BlueFrimFrim/Tardis/README.md

# Tardis_GIT

## DTMF
Uses MC8880C 20-pin DIP
