BlueFrimFrim/Tardis/PCB/Tardis.pdf

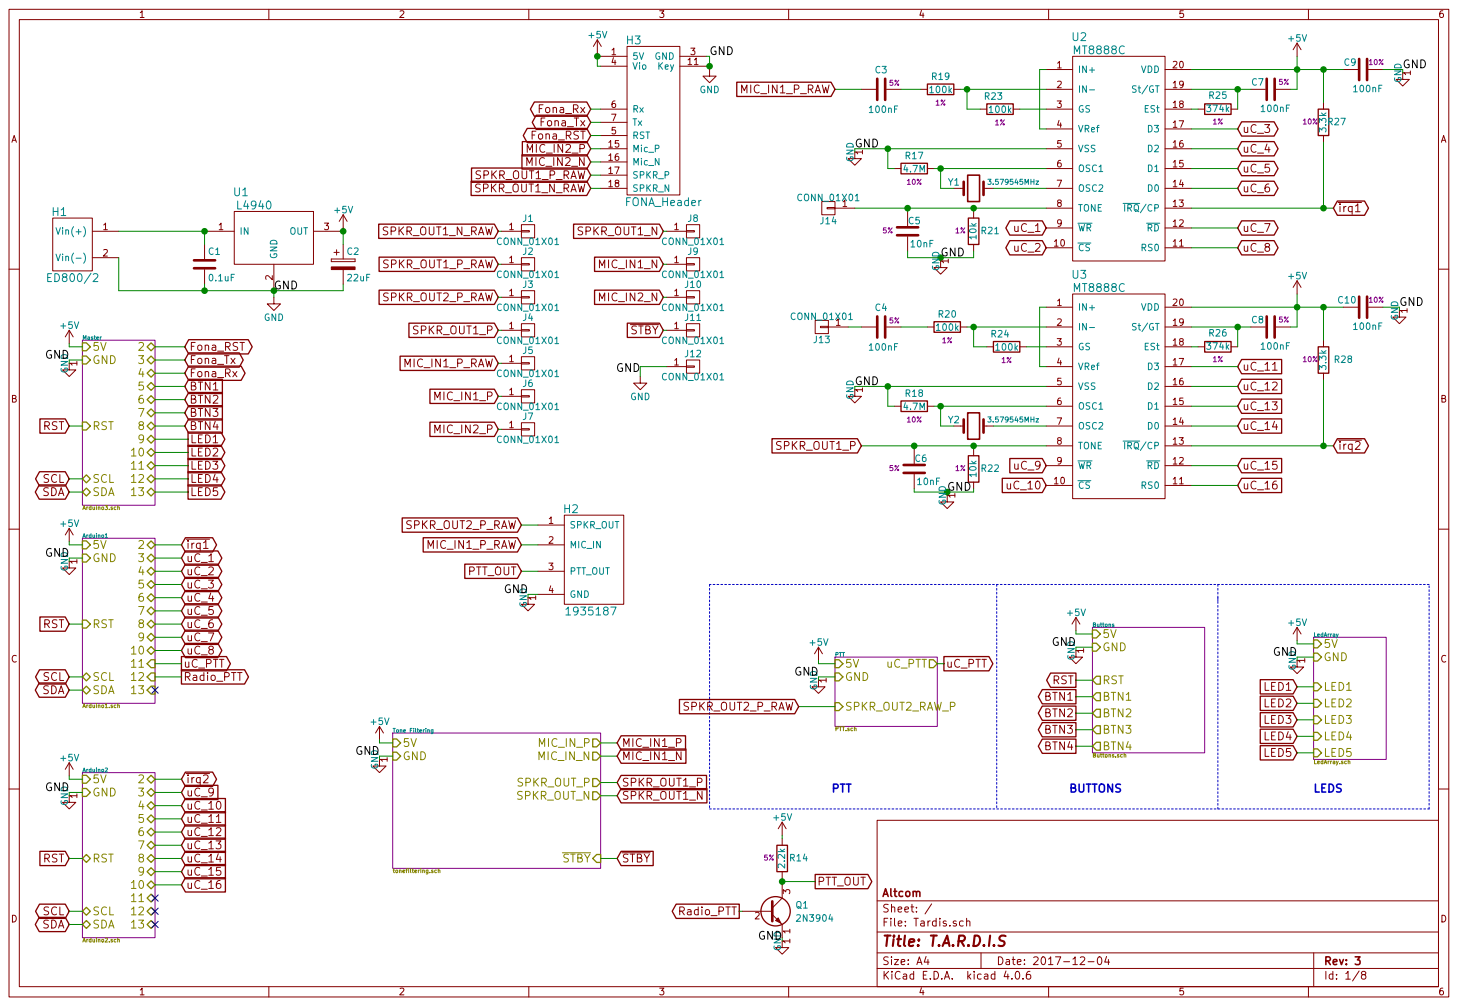
[picture p12: page 1]

File: Tardis.sch Sheet: / Altcom

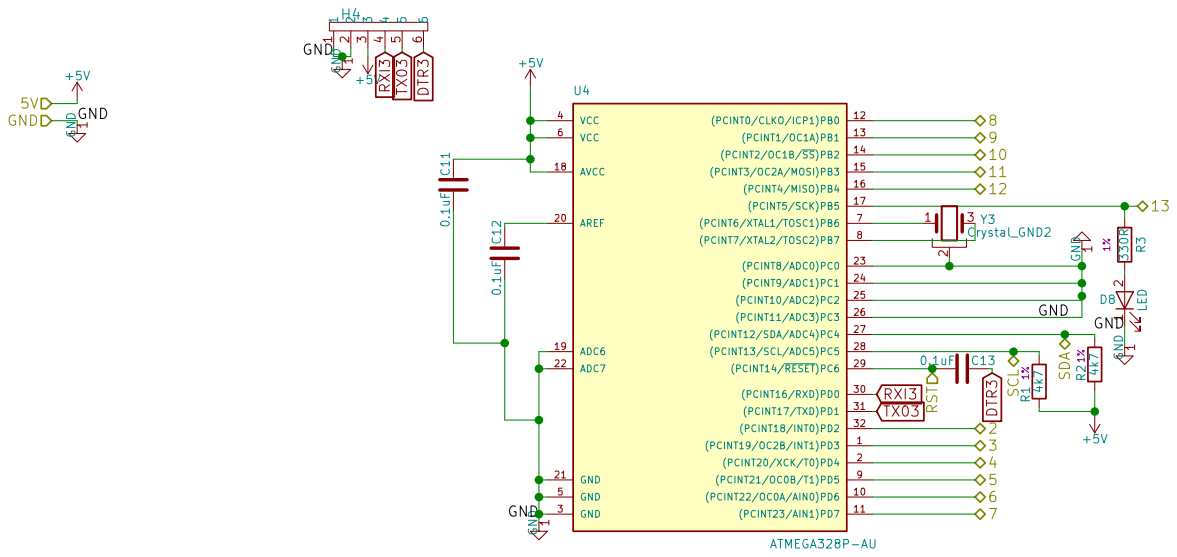
[picture p13: page 2]

File: Arduino2.sch Sheet: /Arduino2/ Altcom

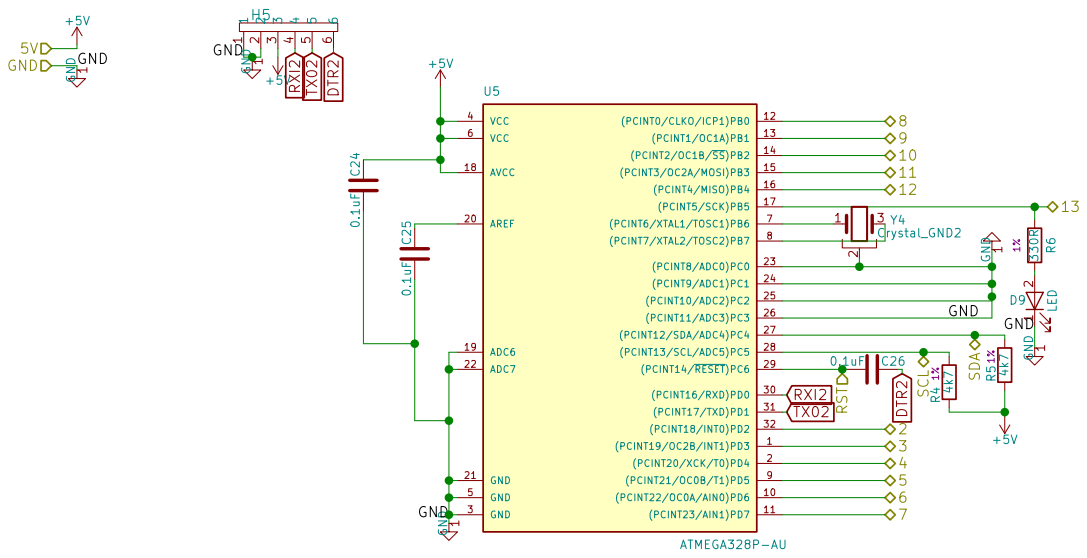
[picture p14: page 3]

File: Arduino1.sch Sheet: /Arduino1/ Altcom

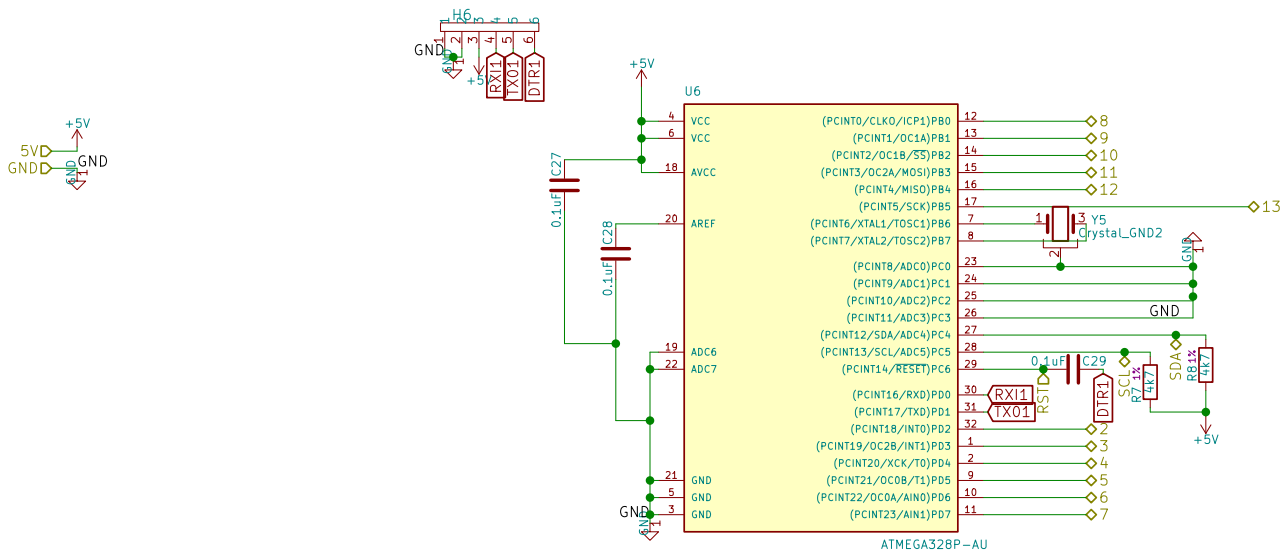
[picture p15: page 4]

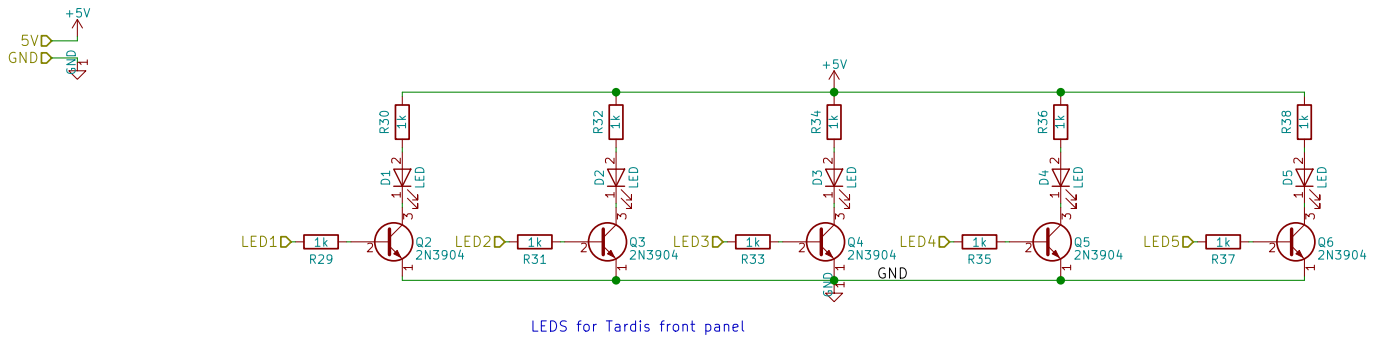
[picture p16: page 5]

LEDS for Tardis front panel

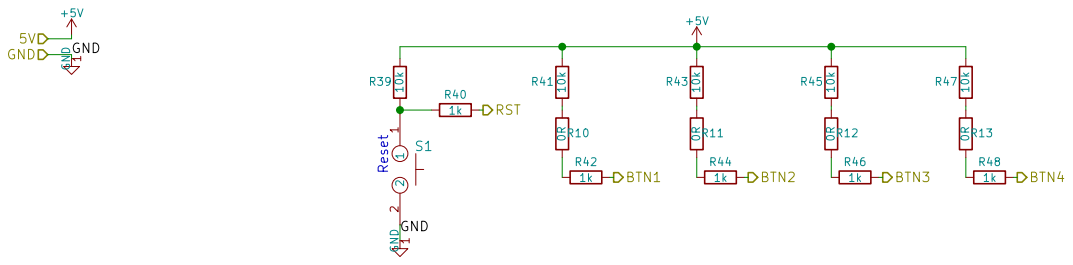
[picture p17: page 6]

File: Buttons.sch Sheet: /Buttons/ Altcom

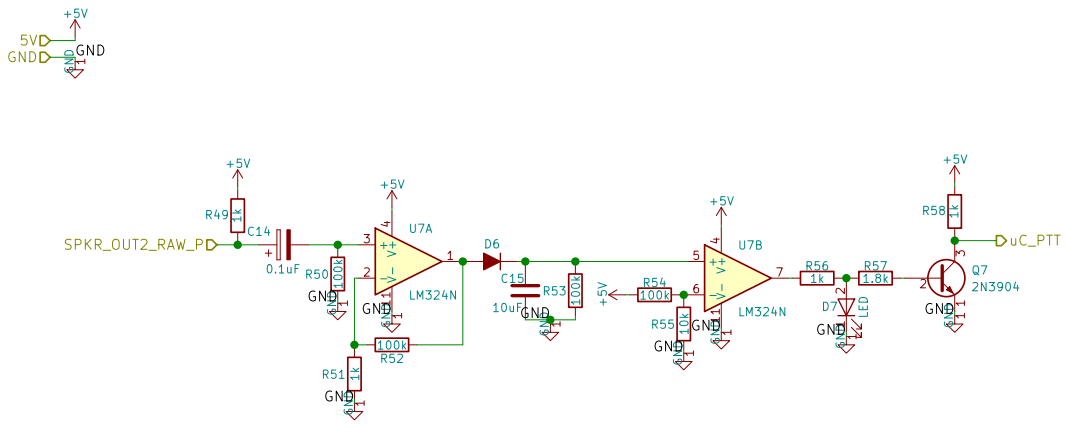
[picture p18: page 7]

File: PTT.sch Sheet: /PTT/ Altcom V+

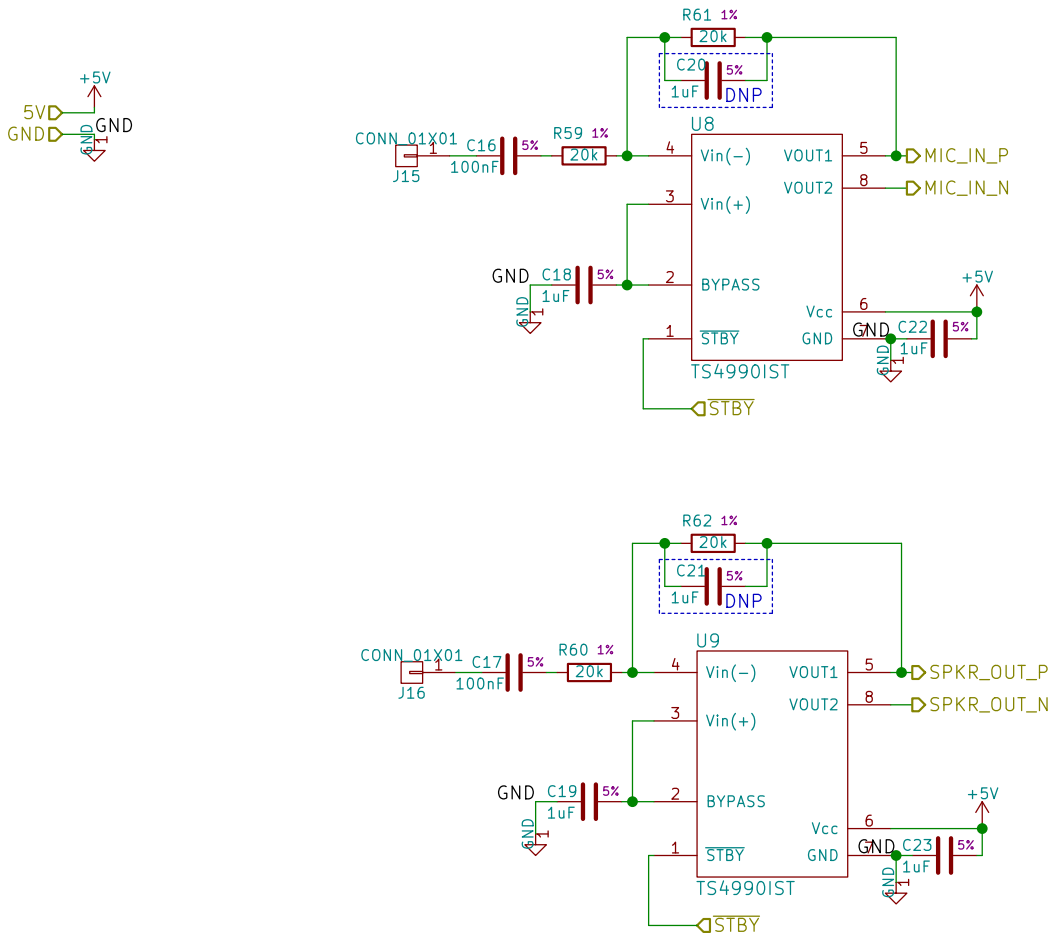
[picture p19: page 8]

Sheet: /Tone Filtering/ Altcom
