BlueFrimFrim/Tardis/PCB/Tardis_SCH_REV3.pdf

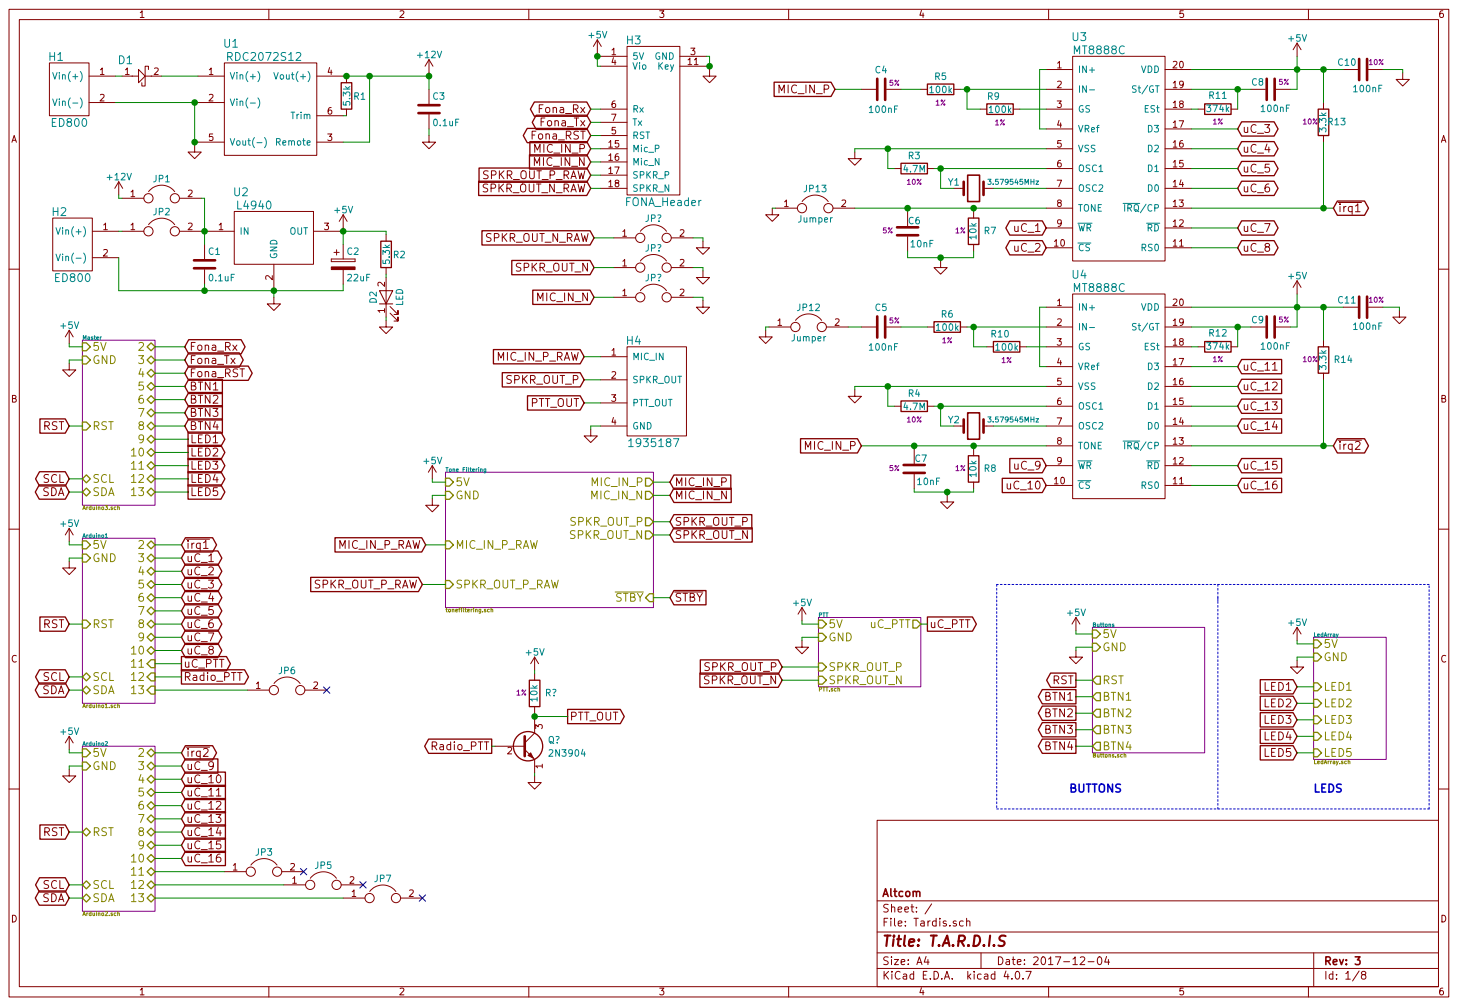
[picture p20: page 1]

File: Tardis.sch Sheet: / Altcom

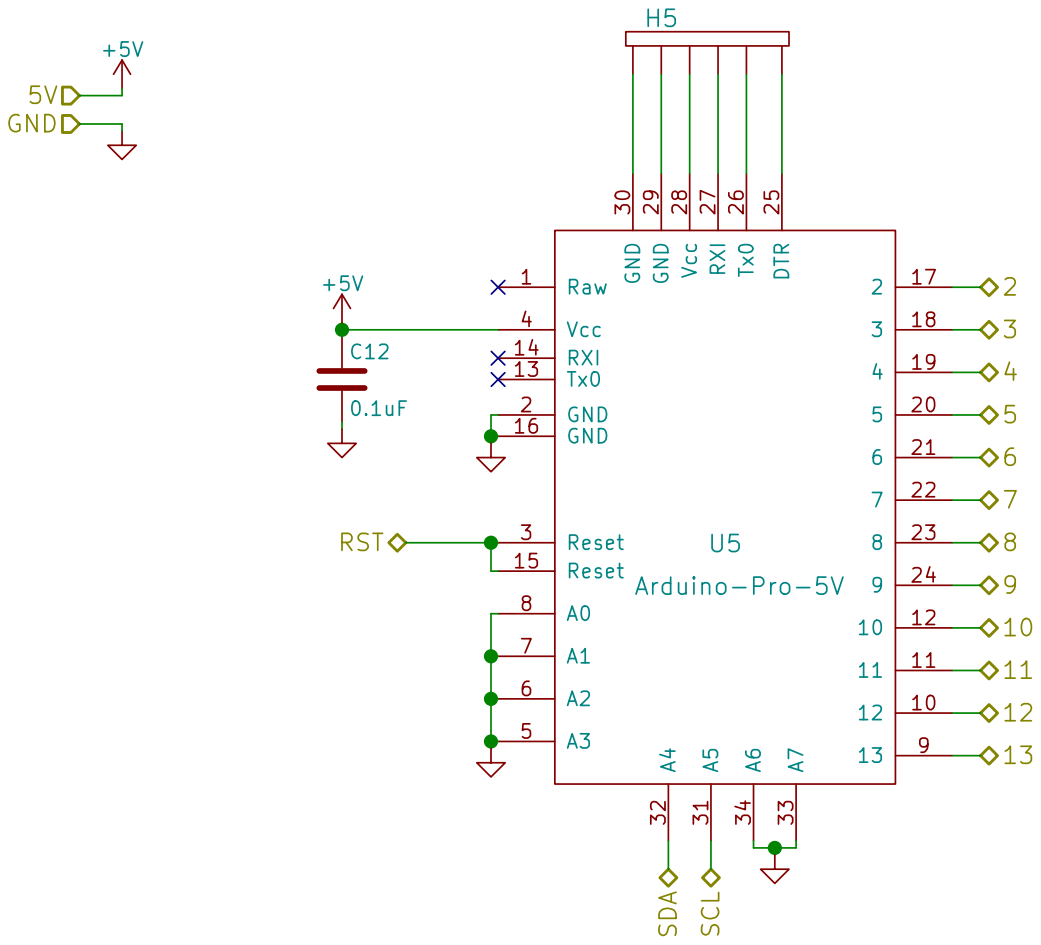
[picture p21: page 2]

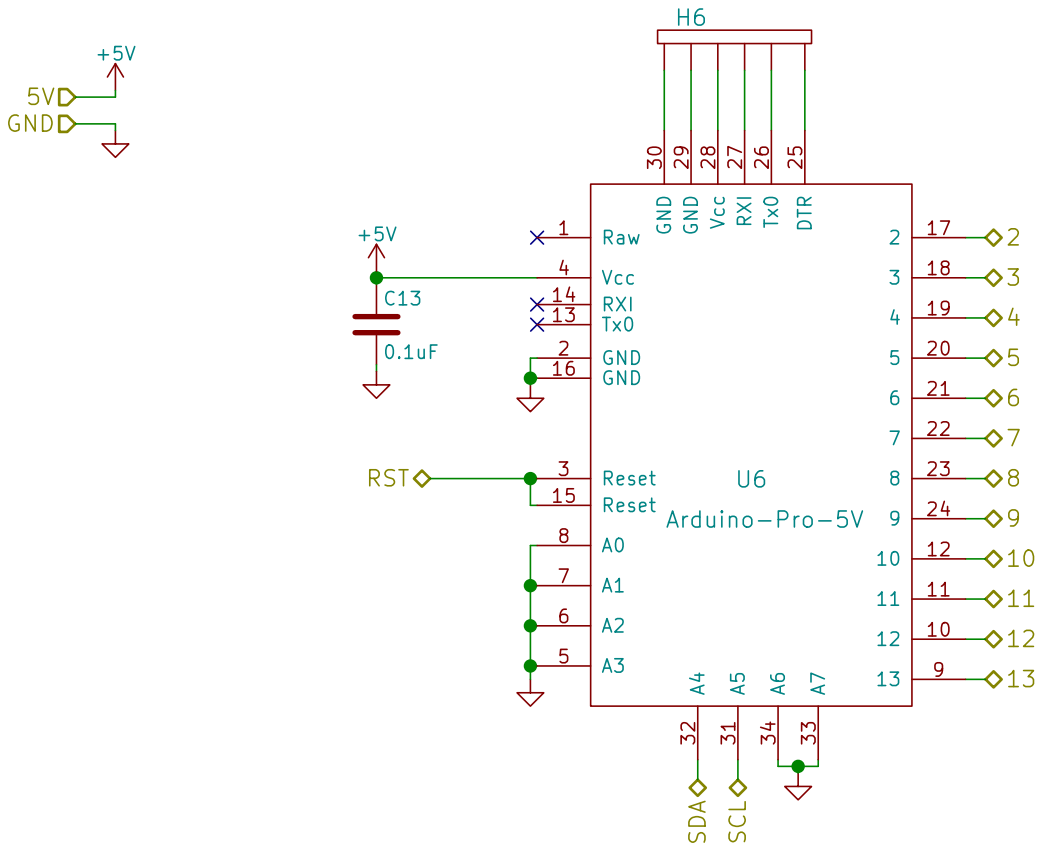
[picture p22: page 3]

File: Arduino1.sch Sheet: /Arduino1/ Altcom

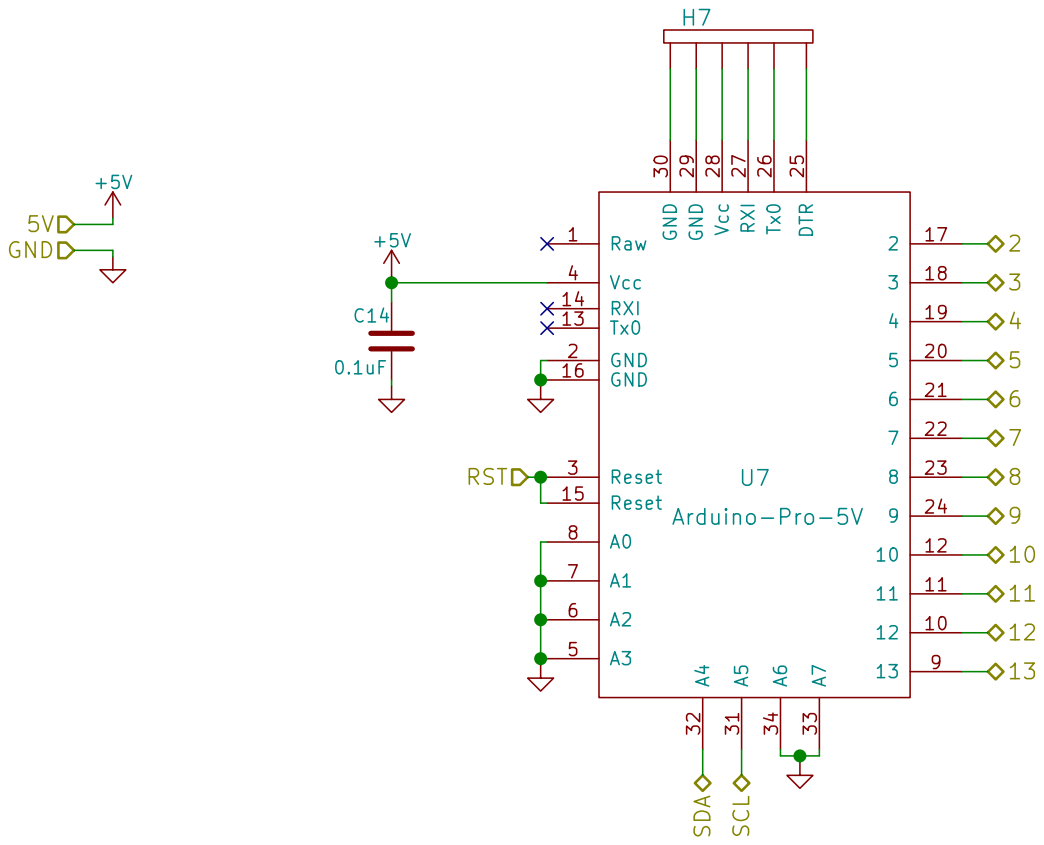
[picture p23: page 4]

File: Arduino3.sch Sheet: /Master/ Altcom

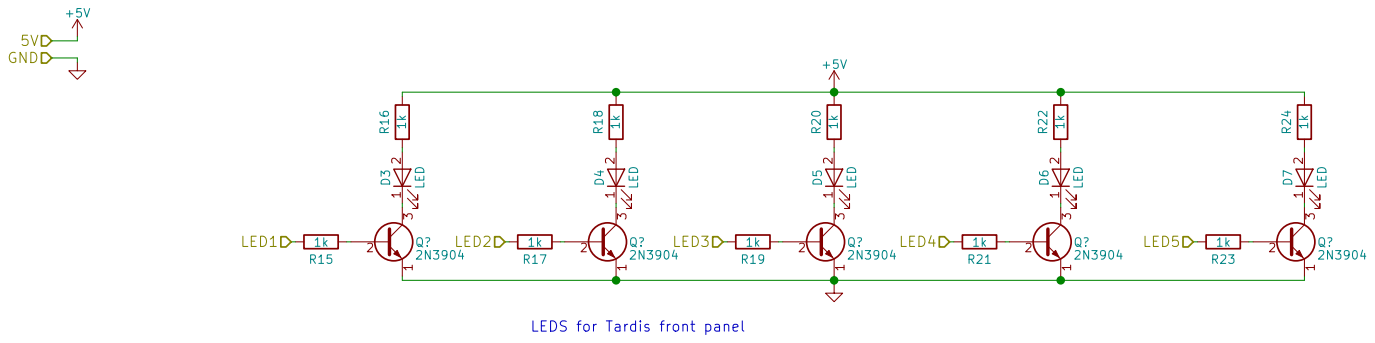
[picture p24: page 5]

LEDS for Tardis front panel

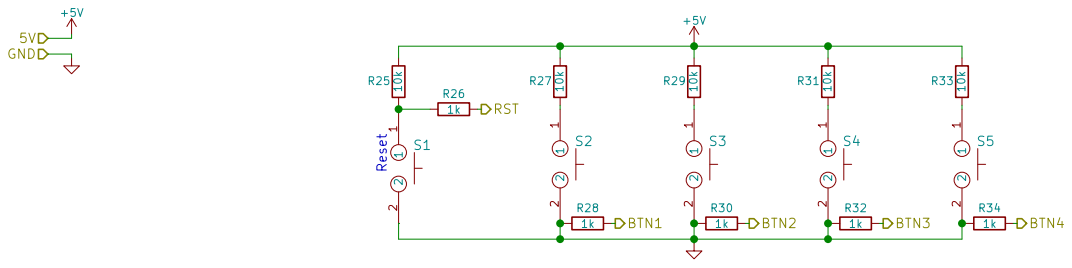
[picture p25: page 6]

File: Buttons.sch Sheet: /Buttons/ Altcom

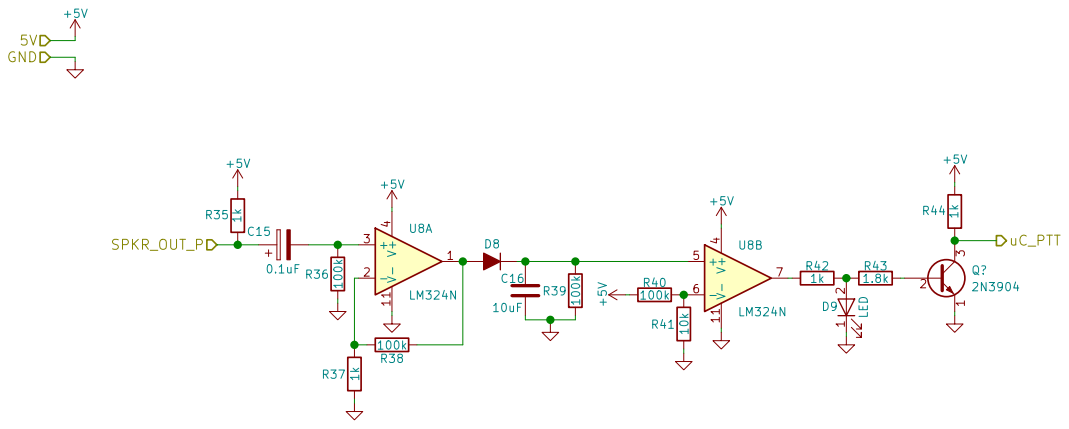
[picture p26: page 7]

File: PTT.sch Sheet: /PTT/ Altcom V+

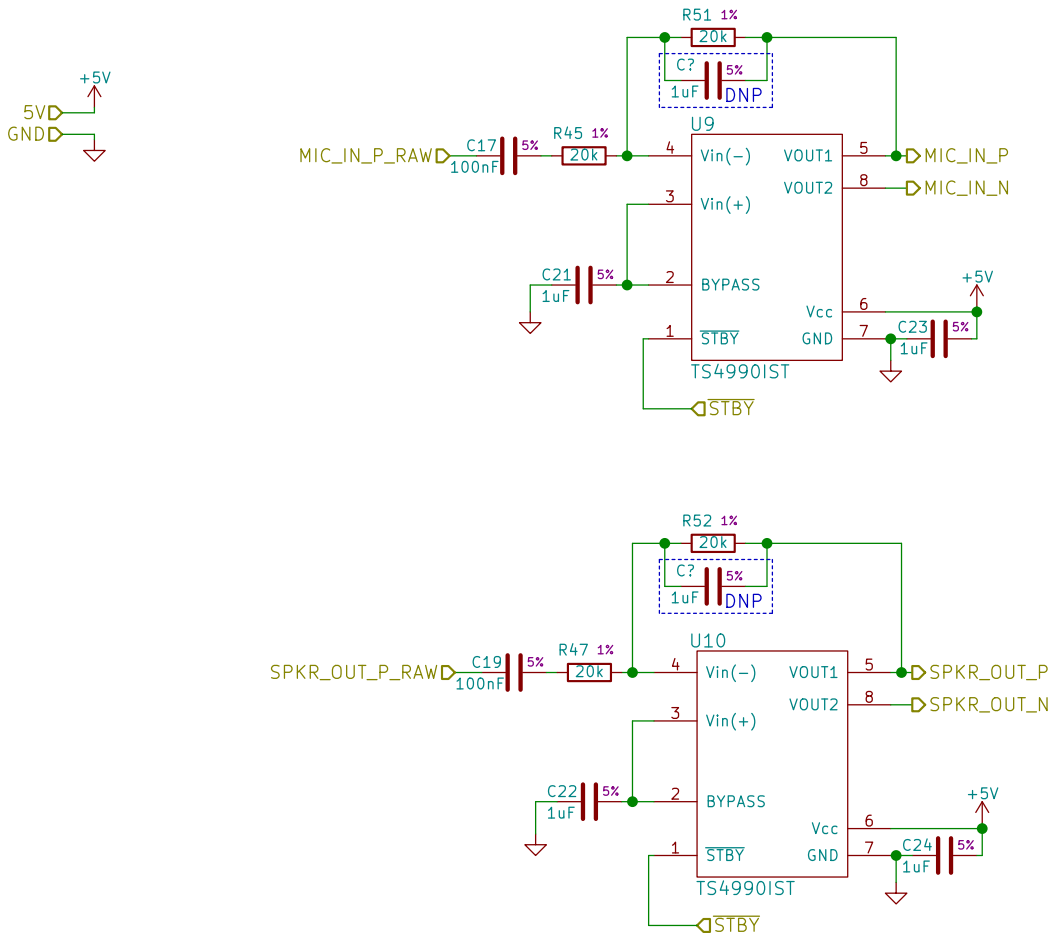
[picture p27: page 8]

Sheet: /Tone Filtering/ Altcom
