BlueFrimFrim/Tardis/PCB/Tardis_SCH_REV2.pdf

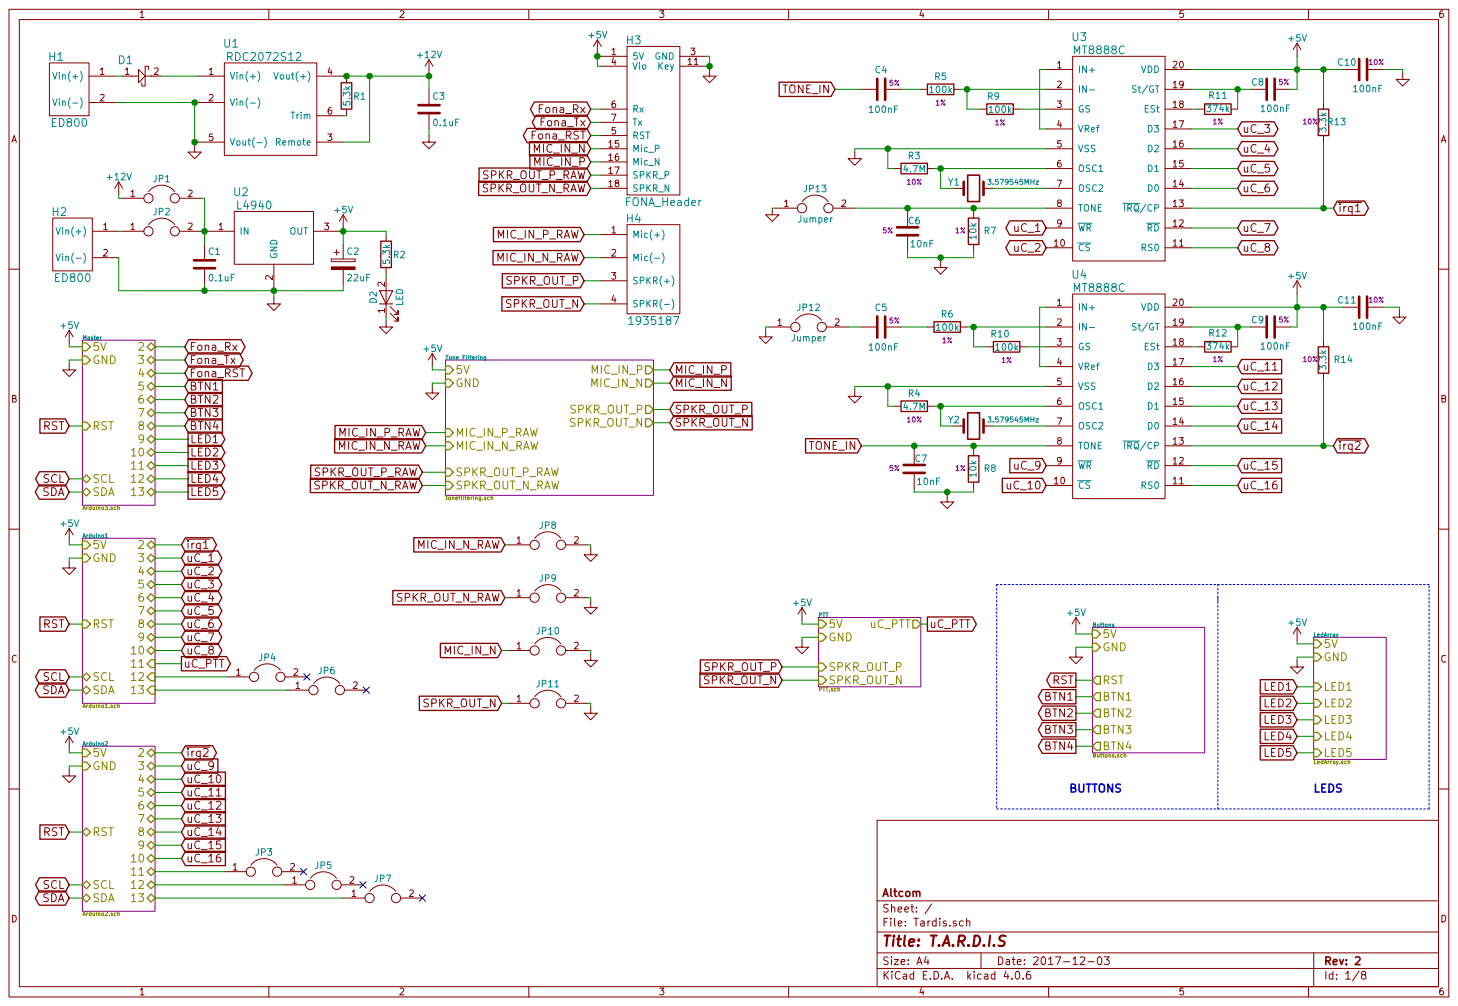
[picture p28: page 1]

File: Tardis.sch Sheet: / Altcom



File: Arduino1.sch Sheet: /Arduino1/ Altcom


File: Arduino3.sch Sheet: /Master/ Altcom

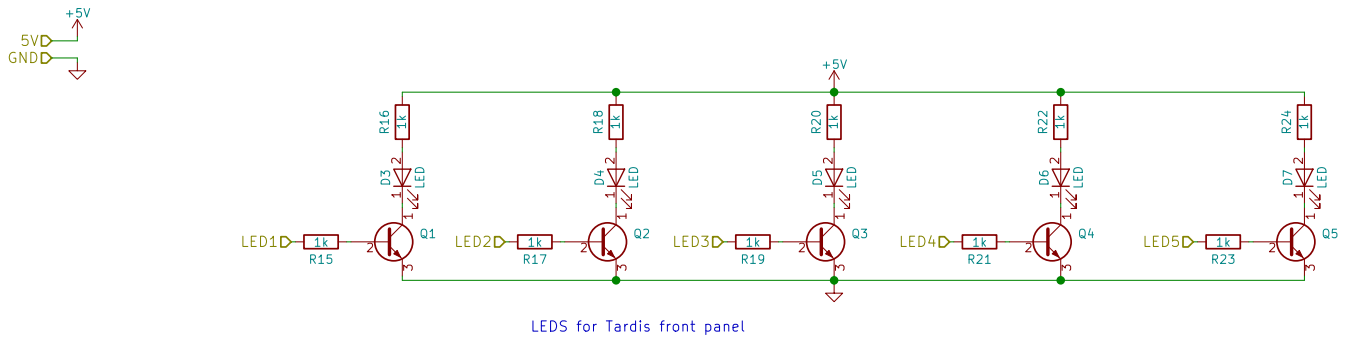
[picture p29: page 5]

LEDS for Tardis front panel

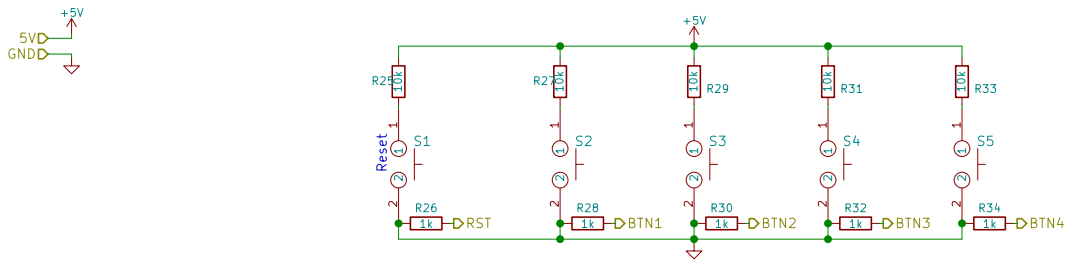
[picture p30: page 6]

Id: 6/8 Title: File: Buttons.sch Sheet: /Buttons/

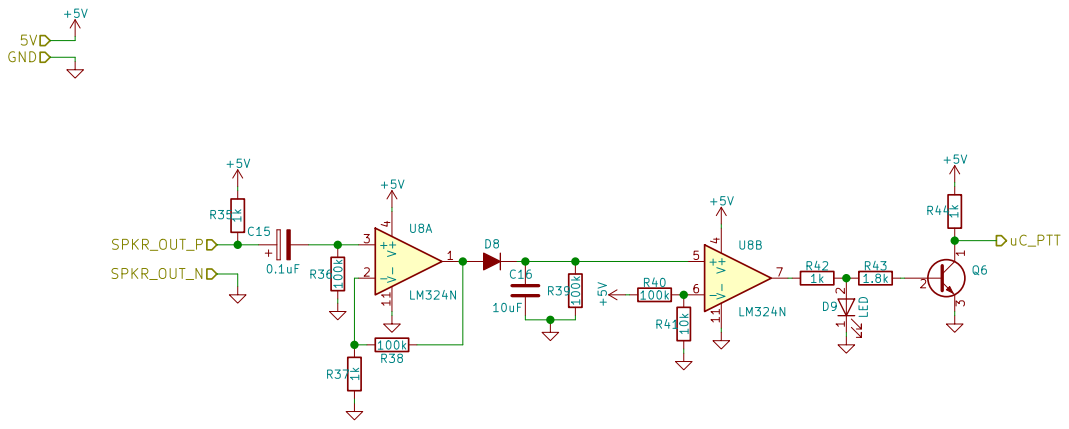
[picture p31: page 7]

Id: 7/8 Title: File: PTT.sch Sheet: /PTT/ V+

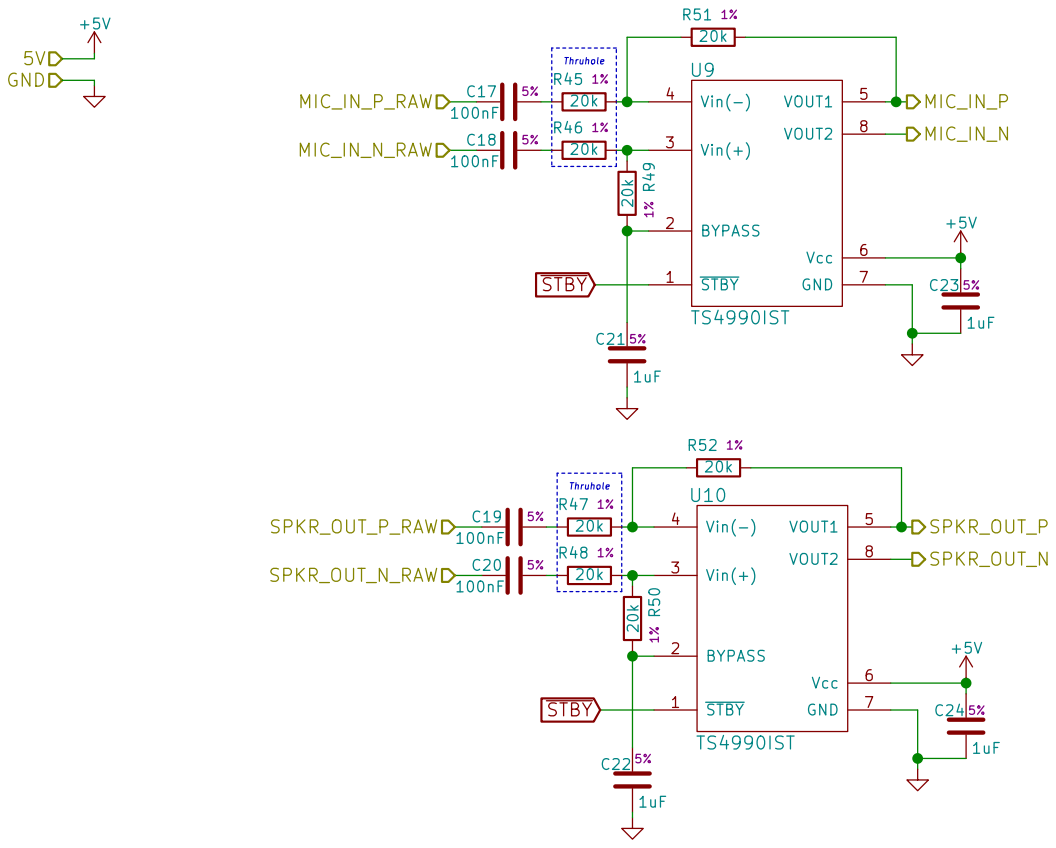
[picture p32: page 8]
