BlueFrimFrim/Tardis/(list of files, drawings)

Other design files:
PCB/Tardis.dsn
