BlueFrimFrim/Tardis/PCB/Tardis.kicad_pcb

## KiCad design PCB/Tardis.kicad_pcb (2018-06-28)

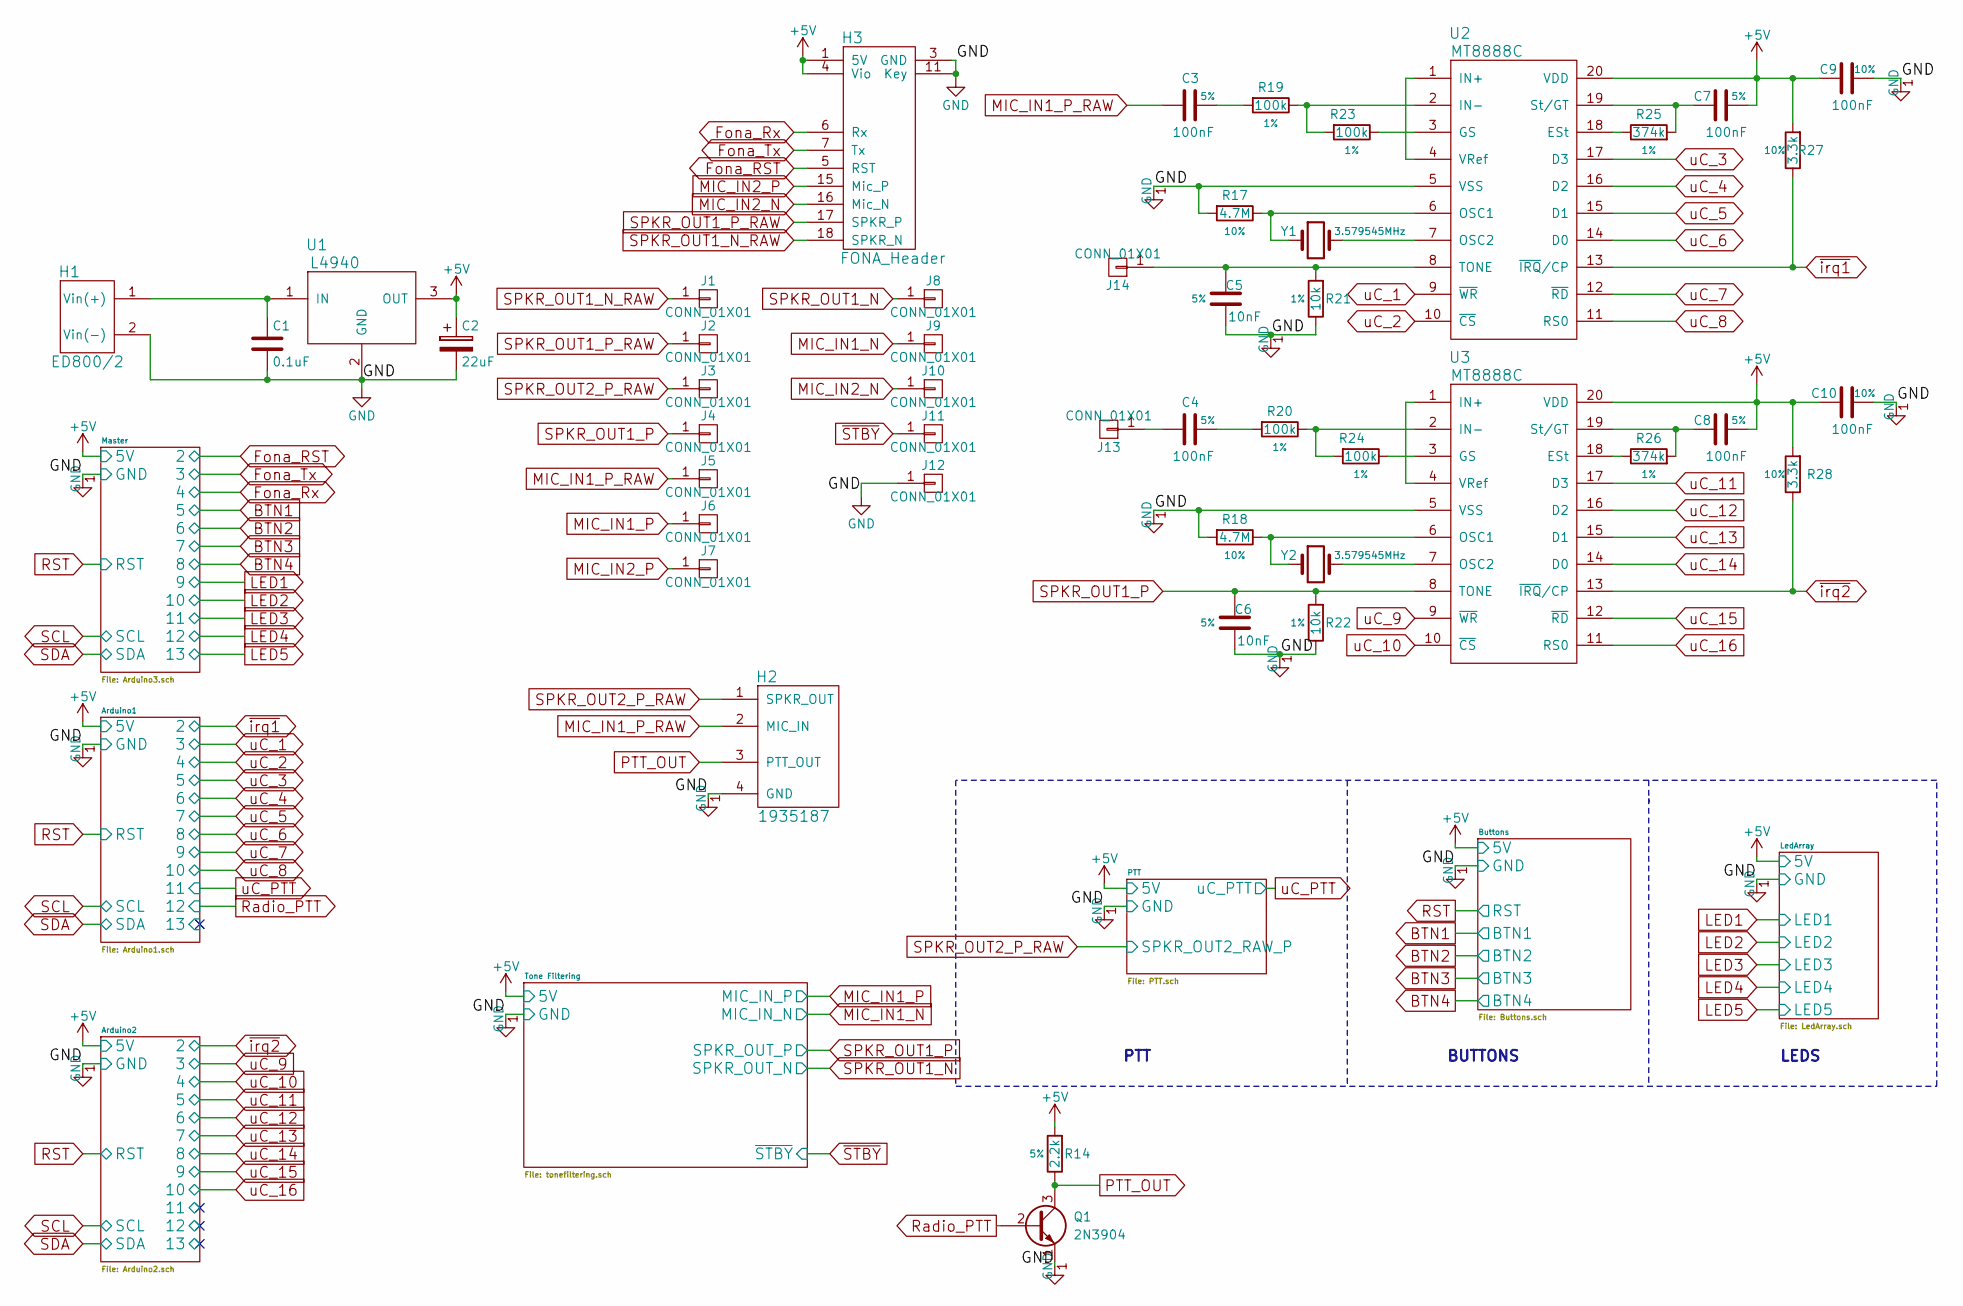
[picture p33: schematic Tardis.sch, T.A.R.D.I.S]

Parts:
C1: 0.1uF; C_0603_HandSoldering
C2: 22uF; RADIAL_5MM
C3, C4, C7, C8, C9, C10: 100nF; C_0603_HandSoldering
C5, C6: 10nF; C_0603_HandSoldering
H1: ED800/2; ED800
H2: 1935187
H3: FONA_Header; Pin_Header_Straight_1x18_Pitch2.54mm
J1, J2, J3, J4, J5, J6, J7, J8, J9, J10, J11, J12, J13, J14: CONN_01X01; Pin_Header_Straight_1x01_Pitch2.54mm
Q1: 2N3904; TO-92_Molded_Narrow
R14: 2.2k; R_0603_HandSoldering
R17, R18: 4.7M; R_0603_HandSoldering
R19, R20, R23, R24: 100k; R_0603_HandSoldering
R21, R22: 10k; R_0603_HandSoldering
R25, R26: 374k; R_0603_HandSoldering
R27, R28: 3.3k; R_0603_HandSoldering
U1: L4940; TO-220-3_Horizontal
U2, U3: MT8888C; SOIC-20
Y1, Y2: 3.579545MHz; Crystal_SMD_HC49-SD_HandSoldering

Connections:
+5V: C2.1, C7.2, C8.2, C9.1, C10.1, H3.1 (5V), H3.4 (Vio), R14.2, R27.2, R28.2, U1.3 (OUT), U2.20 (VDD), U3.20 (VDD); also elsewhere on the board
/GND: C1.2, C2.2, C5.1, C6.1, C9.2, C10.2, H1.2 (Vin(-)), H2.4 (GND), H3.3 (GND), H3.11 (Key), J12.1, Q1.1 (E), R17.2, R18.2, R21.1, R22.1, U1.2 (GND), U2.5 (VSS), U3.5 (VSS); also elsewhere on the board
Fona_RST: H3.5 (RST); also elsewhere on the board
Fona_Rx: H3.6 (Rx); also elsewhere on the board
Fona_Tx: H3.7 (Tx); also elsewhere on the board
MIC_IN1_N: J9.1; also elsewhere on the board
MIC_IN1_P: J6.1; also elsewhere on the board
MIC_IN1_P_RAW: C3.2, H2.2 (MIC_IN), J5.1
MIC_IN2_N: H3.16 (Mic_N), J10.1
MIC_IN2_P: H3.15 (Mic_P), J7.1
unnamed: C1.1, H1.1 (Vin(+)), U1.1 (IN)
unnamed: C3.1, R19.2
unnamed: C4.1, R20.2
unnamed: C4.2, J13.1
unnamed: C5.2, J14.1, R21.2, U2.8 (TONE)
unnamed: C7.1, R25.2, U2.19 (St/GT)
unnamed: C8.1, R26.2, U3.19 (St/GT)
unnamed: R17.1, U2.6 (OSC1), Y1.1
unnamed: R18.1, U3.6 (OSC1), Y2.1
unnamed: R19.1, R23.2, U2.2 (IN-)
unnamed: R20.1, R24.2, U3.2 (IN-)
unnamed: R23.1, U2.3 (GS)
unnamed: R24.1, U3.3 (GS)
unnamed: R25.1, U2.18 (ESt)
unnamed: R26.1, U3.18 (ESt)
unnamed: U2.1 (IN+), U2.4 (VRef)
unnamed: U2.7 (OSC2), Y1.2
unnamed: U3.1 (IN+), U3.4 (VRef)
unnamed: U3.7 (OSC2), Y2.2
PTT_OUT: H2.3 (PTT_OUT), Q1.3 (C), R14.1
Radio_PTT: Q1.2 (B); also elsewhere on the board
SPKR_OUT1_N: J8.1; also elsewhere on the board
SPKR_OUT1_N_RAW: H3.18 (SPKR_N), J1.1
SPKR_OUT1_P: C6.2, J4.1, R22.2, U3.8 (TONE); also elsewhere on the board
SPKR_OUT1_P_RAW: H3.17 (SPKR_P), J2.1
SPKR_OUT2_P_RAW: H2.1 (SPKR_OUT), J3.1; also elsewhere on the board
uC_1: U2.9 (~WR); also elsewhere on the board
uC_2: U2.10 (~CS); also elsewhere on the board
uC_3: U2.17 (D3); also elsewhere on the board
uC_4: U2.16 (D2); also elsewhere on the board
uC_5: U2.15 (D1); also elsewhere on the board
uC_6: U2.14 (D0); also elsewhere on the board
uC_7: U2.12 (~RD); also elsewhere on the board
uC_8: U2.11 (RS0); also elsewhere on the board
uC_9: U3.9 (~WR); also elsewhere on the board
uC_10: U3.10 (~CS); also elsewhere on the board
uC_11: U3.17 (D3); also elsewhere on the board
uC_12: U3.16 (D2); also elsewhere on the board
uC_13: U3.15 (D1); also elsewhere on the board
uC_14: U3.14 (D0); also elsewhere on the board
uC_15: U3.12 (~RD); also elsewhere on the board
uC_16: U3.11 (RS0); also elsewhere on the board
~STBY: J11.1; also elsewhere on the board
~irq1: R27.1, U2.13 (~IRQ~/CP); also elsewhere on the board
~irq2: R28.1, U3.13 (~IRQ~/CP); also elsewhere on the board

Notes on the sheet:
LEDS
BUTTONS
PTT

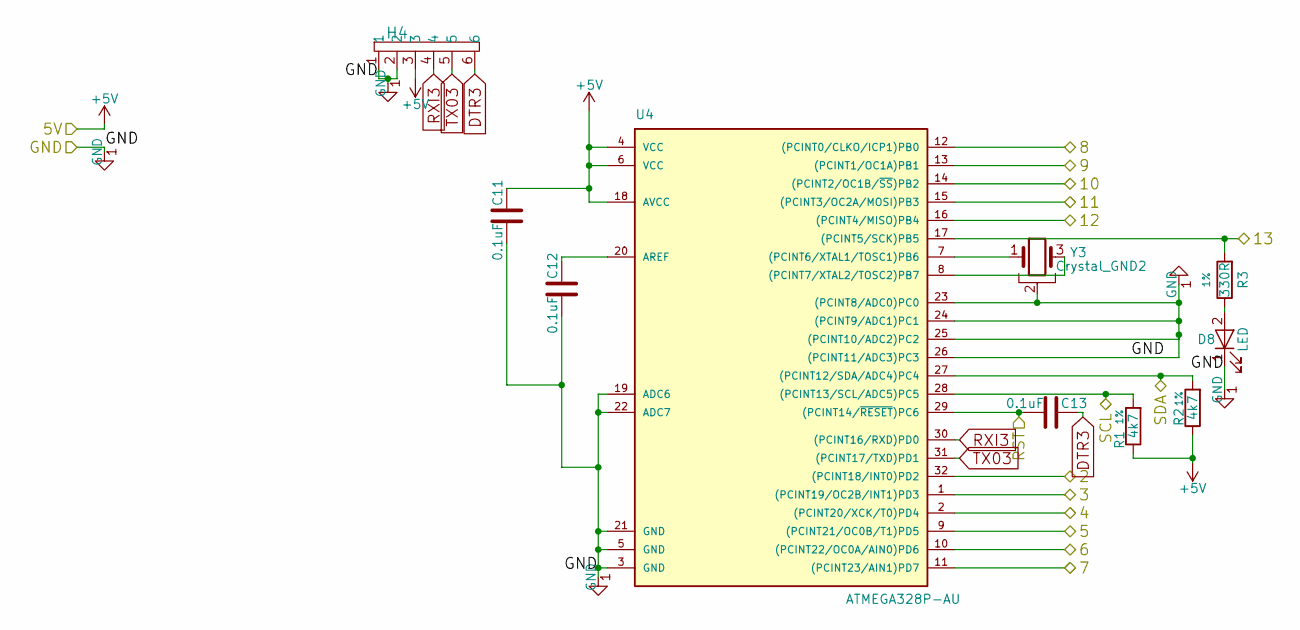
[picture p34: schematic Arduino2.sch, T.A.R.D.I.S]

Parts:
C11, C12, C13: 0.1uF; C_0603_HandSoldering
D8: LED; LED_0805_HandSoldering
H4: Header1; Pin_Header_Straight_1x06_Pitch2.54mm
R1, R2: 4k7; R_0603_HandSoldering
R3: 330R; R_0603_HandSoldering
U4: ATMEGA328P-AU; TQFP-32_7x7mm_Pitch0.8mm
Y3: Crystal_GND2; Resonator_SMD-3pin_7.2x3.0mm_HandSoldering

Connections:
+5V: C11.1, H4.3, R1.1, R2.1, U4.4 (VCC), U4.6 (VCC), U4.18 (AVCC); also elsewhere on the board
/Arduino2/11: U4.15 ((PCINT3/OC2A/MOSI)PB3)
/Arduino2/12: U4.16 ((PCINT4/MISO)PB4)
/Arduino2/13: R3.2, U4.17 ((PCINT5/SCK)PB5)
/GND: C11.2, C12.2, D8.1 (K), H4.1, H4.2, U4.3 (GND), U4.5 (GND), U4.19 (ADC6), U4.21 (GND), U4.22 (ADC7), U4.23 ((PCINT8/ADC0)PC0), U4.24 ((PCINT9/ADC1)PC1), U4.25 ((PCINT10/ADC2)PC2), U4.26 ((PCINT11/ADC3)PC3), Y3.2; also elsewhere on the board
DTR3: C13.1, H4.6
unnamed: C12.1, U4.20 (AREF)
unnamed: D8.2 (A), R3.1
unnamed: U4.7 ((PCINT6/XTAL1/TOSC1)PB6), Y3.1
unnamed: U4.8 ((PCINT7/XTAL2/TOSC2)PB7), Y3.3
RST: C13.2, U4.29 ((PCINT14/~RESET~)PC6); also elsewhere on the board
RXI3: H4.4, U4.30 ((PCINT16/RXD)PD0)
SCL: R1.2, U4.28 ((PCINT13/SCL/ADC5)PC5); also elsewhere on the board
SDA: R2.2, U4.27 ((PCINT12/SDA/ADC4)PC4); also elsewhere on the board
TX03: H4.5, U4.31 ((PCINT17/TXD)PD1)
uC_9: U4.1 ((PCINT19/OC2B/INT1)PD3); also elsewhere on the board
uC_10: U4.2 ((PCINT20/XCK/T0)PD4); also elsewhere on the board
uC_11: U4.9 ((PCINT21/OC0B/T1)PD5); also elsewhere on the board
uC_12: U4.10 ((PCINT22/OC0A/AIN0)PD6); also elsewhere on the board
uC_13: U4.11 ((PCINT23/AIN1)PD7); also elsewhere on the board
uC_14: U4.12 ((PCINT0/CLKO/ICP1)PB0); also elsewhere on the board
uC_15: U4.13 ((PCINT1/OC1A)PB1); also elsewhere on the board
uC_16: U4.14 ((PCINT2/OC1B/~SS~)PB2); also elsewhere on the board
~irq2: U4.32 ((PCINT18/INT0)PD2); also elsewhere on the board

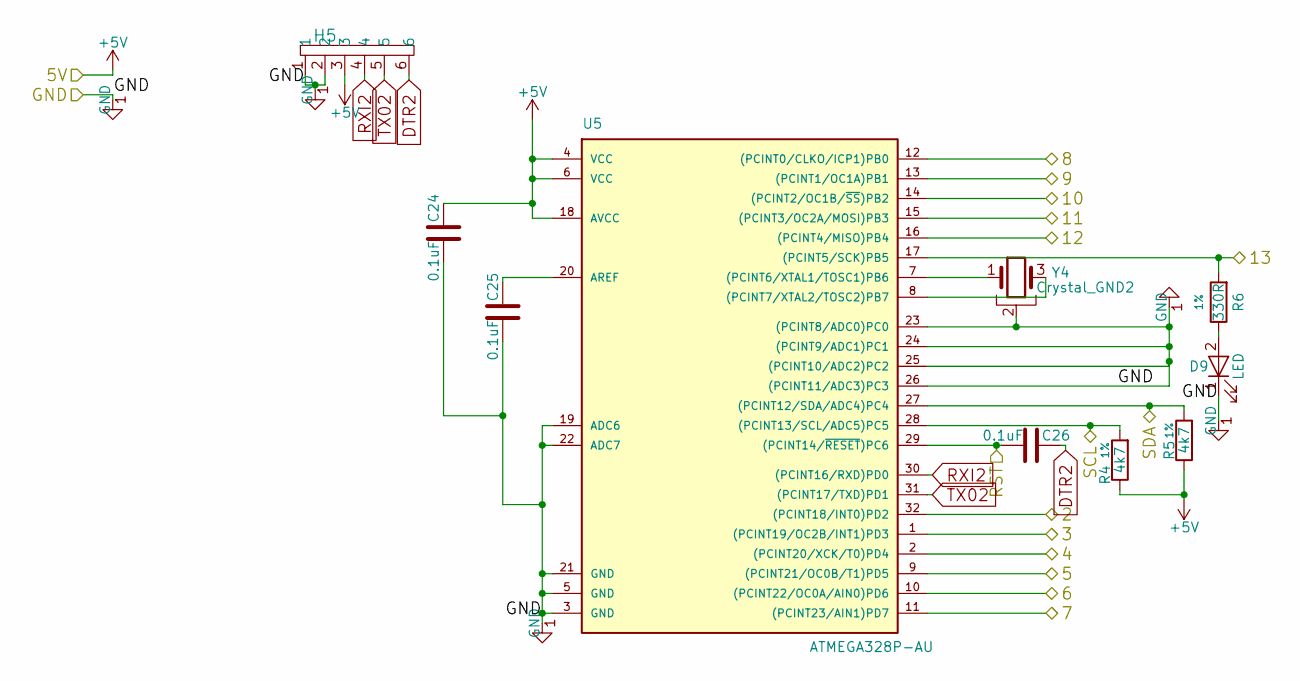
[picture p35: schematic Arduino1.sch, T.A.R.D.I.S]

Parts:
C24, C25, C26: 0.1uF; C_0603_HandSoldering
D9: LED; LED_0805_HandSoldering
H5: Header1; Pin_Header_Straight_1x06_Pitch2.54mm
R4, R5: 4k7; R_0603_HandSoldering
R6: 330R; R_0603_HandSoldering
U5: ATMEGA328P-AU; TQFP-32_7x7mm_Pitch0.8mm
Y4: Crystal_GND2; Resonator_SMD-3pin_7.2x3.0mm_HandSoldering

Connections:
+5V: C24.1, H5.3, R4.1, R5.1, U5.4 (VCC), U5.6 (VCC), U5.18 (AVCC); also elsewhere on the board
/Arduino1/13: R6.2, U5.17 ((PCINT5/SCK)PB5)
/GND: C24.2, C25.2, D9.1 (K), H5.1, H5.2, U5.3 (GND), U5.5 (GND), U5.19 (ADC6), U5.21 (GND), U5.22 (ADC7), U5.23 ((PCINT8/ADC0)PC0), U5.24 ((PCINT9/ADC1)PC1), U5.25 ((PCINT10/ADC2)PC2), U5.26 ((PCINT11/ADC3)PC3), Y4.2; also elsewhere on the board
DTR2: C26.1, H5.6
unnamed: C25.1, U5.20 (AREF)
unnamed: D9.2 (A), R6.1
unnamed: U5.7 ((PCINT6/XTAL1/TOSC1)PB6), Y4.1
unnamed: U5.8 ((PCINT7/XTAL2/TOSC2)PB7), Y4.3
RST: C26.2, U5.29 ((PCINT14/~RESET~)PC6); also elsewhere on the board
RXI2: H5.4, U5.30 ((PCINT16/RXD)PD0)
Radio_PTT: U5.16 ((PCINT4/MISO)PB4); also elsewhere on the board
SCL: R4.2, U5.28 ((PCINT13/SCL/ADC5)PC5); also elsewhere on the board
SDA: R5.2, U5.27 ((PCINT12/SDA/ADC4)PC4); also elsewhere on the board
TX02: H5.5, U5.31 ((PCINT17/TXD)PD1)
uC_1: U5.1 ((PCINT19/OC2B/INT1)PD3); also elsewhere on the board
uC_2: U5.2 ((PCINT20/XCK/T0)PD4); also elsewhere on the board
uC_3: U5.9 ((PCINT21/OC0B/T1)PD5); also elsewhere on the board
uC_4: U5.10 ((PCINT22/OC0A/AIN0)PD6); also elsewhere on the board
uC_5: U5.11 ((PCINT23/AIN1)PD7); also elsewhere on the board
uC_6: U5.12 ((PCINT0/CLKO/ICP1)PB0); also elsewhere on the board
uC_7: U5.13 ((PCINT1/OC1A)PB1); also elsewhere on the board
uC_8: U5.14 ((PCINT2/OC1B/~SS~)PB2); also elsewhere on the board
uC_PTT: U5.15 ((PCINT3/OC2A/MOSI)PB3); also elsewhere on the board
~irq1: U5.32 ((PCINT18/INT0)PD2); also elsewhere on the board

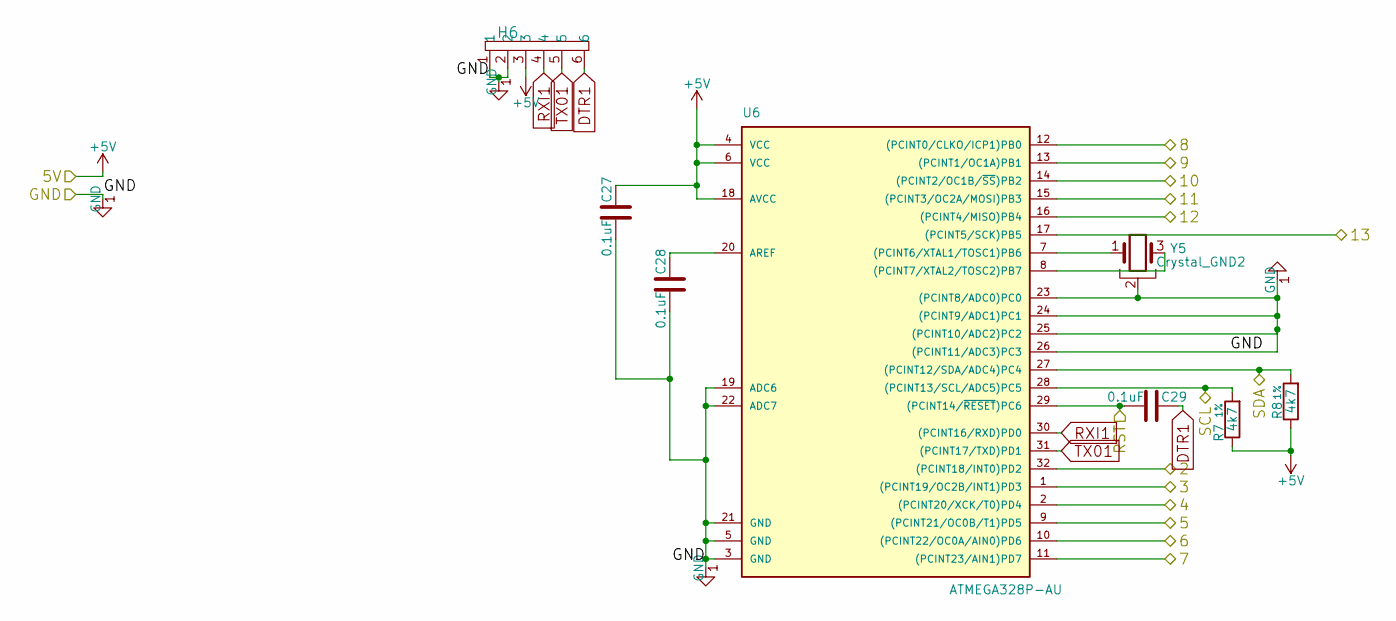
[picture p36: schematic Arduino3.sch, T.A.R.D.I.S]

Parts:
C27, C28, C29: 0.1uF; C_0603_HandSoldering
H6: Header1; Pin_Header_Straight_1x06_Pitch2.54mm
R7, R8: 4k7; R_0603_HandSoldering
U6: ATMEGA328P-AU; TQFP-32_7x7mm_Pitch0.8mm
Y5: Crystal_GND2; Resonator_SMD-3pin_7.2x3.0mm_HandSoldering

Connections:
+5V: C27.1, H6.3, R7.1, R8.1, U6.4 (VCC), U6.6 (VCC), U6.18 (AVCC); also elsewhere on the board
/GND: C27.2, C28.2, H6.1, H6.2, U6.3 (GND), U6.5 (GND), U6.19 (ADC6), U6.21 (GND), U6.22 (ADC7), U6.23 ((PCINT8/ADC0)PC0), U6.24 ((PCINT9/ADC1)PC1), U6.25 ((PCINT10/ADC2)PC2), U6.26 ((PCINT11/ADC3)PC3), Y5.2; also elsewhere on the board
BTN1: U6.9 ((PCINT21/OC0B/T1)PD5); also elsewhere on the board
BTN2: U6.10 ((PCINT22/OC0A/AIN0)PD6); also elsewhere on the board
BTN3: U6.11 ((PCINT23/AIN1)PD7); also elsewhere on the board
BTN4: U6.12 ((PCINT0/CLKO/ICP1)PB0); also elsewhere on the board
DTR1: C29.1, H6.6
Fona_RST: U6.32 ((PCINT18/INT0)PD2); also elsewhere on the board
Fona_Rx: U6.2 ((PCINT20/XCK/T0)PD4); also elsewhere on the board
Fona_Tx: U6.1 ((PCINT19/OC2B/INT1)PD3); also elsewhere on the board
LED1: U6.13 ((PCINT1/OC1A)PB1); also elsewhere on the board
LED2: U6.14 ((PCINT2/OC1B/~SS~)PB2); also elsewhere on the board
LED3: U6.15 ((PCINT3/OC2A/MOSI)PB3); also elsewhere on the board
LED4: U6.16 ((PCINT4/MISO)PB4); also elsewhere on the board
LED5: U6.17 ((PCINT5/SCK)PB5); also elsewhere on the board
unnamed: C28.1, U6.20 (AREF)
unnamed: U6.7 ((PCINT6/XTAL1/TOSC1)PB6), Y5.1
unnamed: U6.8 ((PCINT7/XTAL2/TOSC2)PB7), Y5.3
RST: C29.2, U6.29 ((PCINT14/~RESET~)PC6); also elsewhere on the board
RXI1: H6.4, U6.30 ((PCINT16/RXD)PD0)
SCL: R7.2, U6.28 ((PCINT13/SCL/ADC5)PC5); also elsewhere on the board
SDA: R8.2, U6.27 ((PCINT12/SDA/ADC4)PC4); also elsewhere on the board
TX01: H6.5, U6.31 ((PCINT17/TXD)PD1)

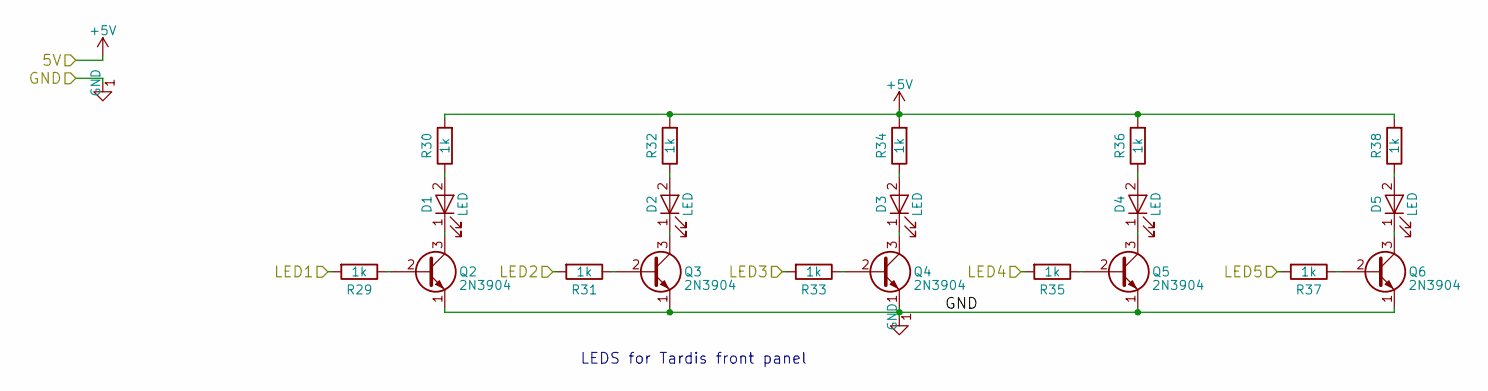
[picture p37: schematic LedArray.sch, T.A.R.D.I.S]

Parts:
D1, D2, D3, D4, D5: LED; LED_D5.0mm
Q2, Q3, Q4, Q5, Q6: 2N3904; TO-92_Molded_Narrow
R29, R30, R31, R32, R33, R34, R35, R36, R37, R38: 1k; R_0603_HandSoldering

Connections:
+5V: R30.2, R32.2, R34.2, R36.2, R38.2; also elsewhere on the board
/GND: Q2.1 (E), Q3.1 (E), Q4.1 (E), Q5.1 (E), Q6.1 (E); also elsewhere on the board
LED1: R29.2; also elsewhere on the board
LED2: R31.2; also elsewhere on the board
LED3: R33.2; also elsewhere on the board
LED4: R35.2; also elsewhere on the board
LED5: R37.2; also elsewhere on the board
unnamed: D1.1 (K), Q2.3 (C)
unnamed: D1.2 (A), R30.1
unnamed: D2.1 (K), Q3.3 (C)
unnamed: D2.2 (A), R32.1
unnamed: D3.1 (K), Q4.3 (C)
unnamed: D3.2 (A), R34.1
unnamed: D4.1 (K), Q5.3 (C)
unnamed: D4.2 (A), R36.1
unnamed: D5.1 (K), Q6.3 (C)
unnamed: D5.2 (A), R38.1
unnamed: Q2.2 (B), R29.1
unnamed: Q3.2 (B), R31.1
unnamed: Q4.2 (B), R33.1
unnamed: Q5.2 (B), R35.1
unnamed: Q6.2 (B), R37.1

Notes on the sheet:
LEDS for Tardis front panel

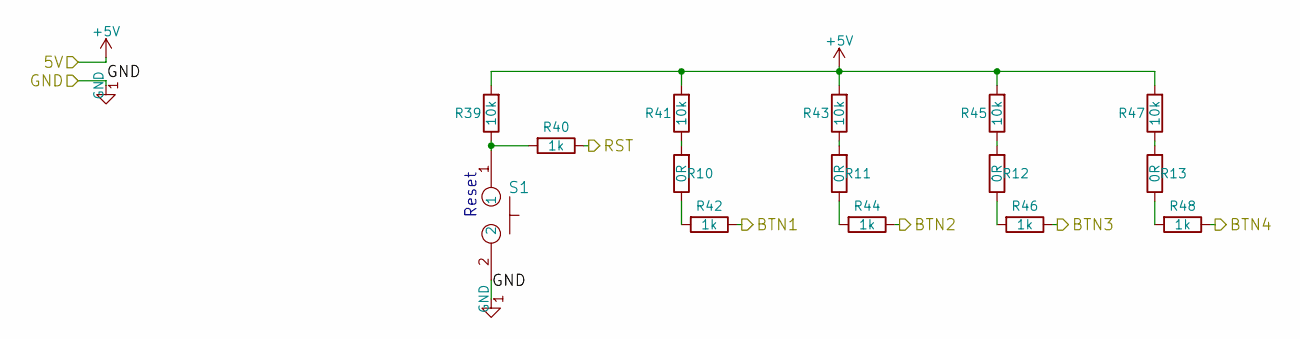
[picture p38: schematic Buttons.sch, T.A.R.D.I.S]

Parts:
R10, R11, R12, R13: 0R; R_Axial_DIN0204_L3.6mm_D1.6mm_P2.54mm_Vertical
R39, R41, R43, R45, R47: 10k; R_0603_HandSoldering
R40, R42, R44, R46, R48: 1k; R_0603_HandSoldering
S1: mom_button; SW_TH_Tactile_Omron_B3F-10xx

Connections:
+5V: R39.2, R41.2, R43.2, R45.2, R47.2; also elsewhere on the board
/GND: S1.2; also elsewhere on the board
BTN1: R42.1; also elsewhere on the board
BTN2: R44.1; also elsewhere on the board
BTN3: R46.1; also elsewhere on the board
BTN4: R48.1; also elsewhere on the board
unnamed: R10.1, R42.2
unnamed: R10.2, R41.1
unnamed: R11.1, R44.2
unnamed: R11.2, R43.1
unnamed: R12.1, R46.2
unnamed: R12.2, R45.1
unnamed: R13.1, R48.2
unnamed: R13.2, R47.1
unnamed: R39.1, R40.2, S1.1
RST: R40.1; also elsewhere on the board

Notes on the sheet:
Reset

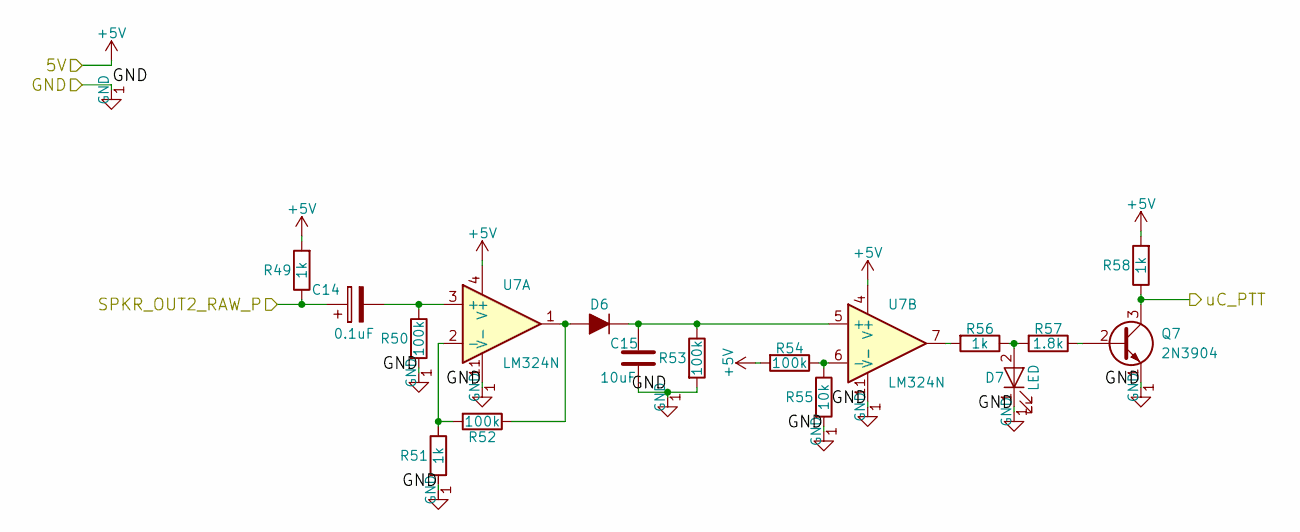
[picture p39: schematic PTT.sch, T.A.R.D.I.S]

Parts:
C14: 0.1uF; CP_Radial_D5.0mm_P2.00mm
C15: 10uF; C_0603_HandSoldering
D6: D_ALT; D_SOD-323_HandSoldering
D7: LED; LED_0805_HandSoldering
Q7: 2N3904; TO-92_Molded_Narrow
R49, R51, R56, R58: 1k; R_0603_HandSoldering
R50, R52, R53, R54: 100k; R_0603_HandSoldering
R55: 10k; R_0603_HandSoldering
R57: 1.8k; R_0603_HandSoldering
U7: LM324N; SOIC-14_N

Connections:
+5V: R49.2, R54.2, R58.2, U7.4 (V+); also elsewhere on the board
/GND: C15.2, D7.1 (K), Q7.1 (E), R50.2, R51.2, R53.2, R55.2, U7.11 (V-); also elsewhere on the board
unnamed: C14.2, R50.1, U7.3 (+)
unnamed: C15.1, D6.1 (K), R53.1, U7.5 (+)
unnamed: D6.2 (A), R52.1, U7.1
unnamed: D7.2 (A), R56.1, R57.2
unnamed: Q7.2 (B), R57.1
unnamed: R51.1, R52.2, U7.2 (-)
unnamed: R54.1, R55.1, U7.6 (-)
unnamed: R56.2, U7.7
SPKR_OUT2_P_RAW: C14.1, R49.1; also elsewhere on the board
uC_PTT: Q7.3 (C), R58.1; also elsewhere on the board

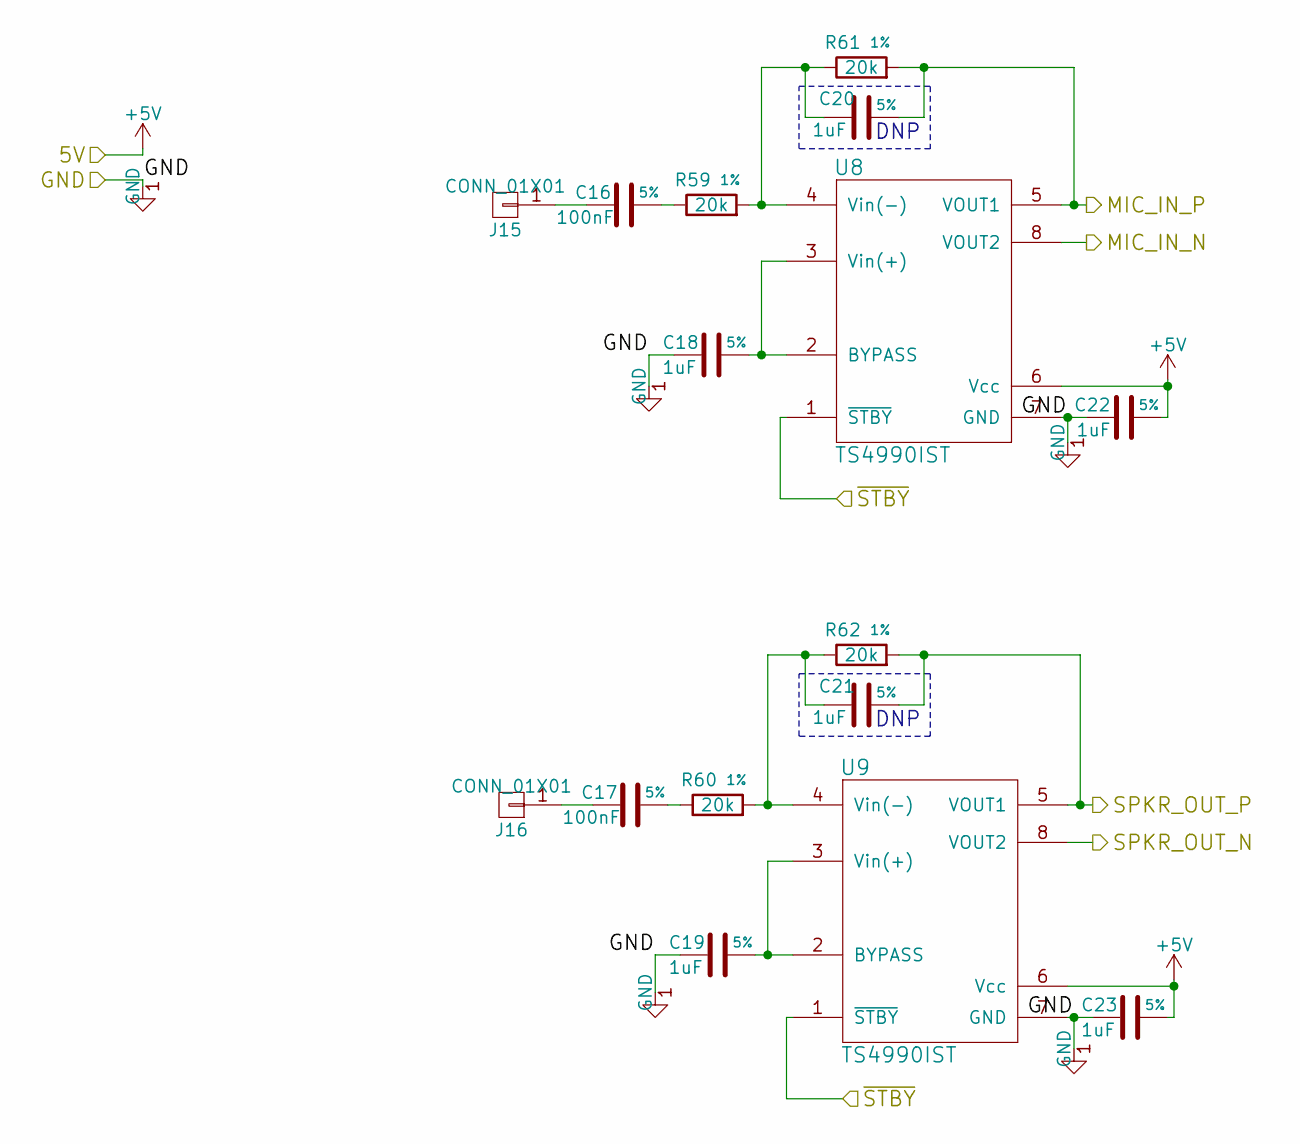
[picture p40: schematic tonefiltering.sch, T.A.R.D.I.S]

Parts:
C16, C17: 100nF; C_0603_HandSoldering
C18, C19, C20, C21, C22, C23: 1uF; C_0603_HandSoldering
J15, J16: CONN_01X01; Pin_Header_Straight_1x01_Pitch2.54mm
R59, R60, R61, R62: 20k; R_0603_HandSoldering
U8, U9: TS4990IST; MSOP-8_3x3mm_Pitch0.65mm

Connections:
+5V: C22.2, C23.1, U8.6 (Vcc), U9.6 (Vcc); also elsewhere on the board
/GND: C18.2, C19.2, C22.1, C23.2, U8.7 (GND), U9.7 (GND); also elsewhere on the board
MIC_IN1_N: U8.8 (VOUT2); also elsewhere on the board
MIC_IN1_P: C20.1, R61.2, U8.5 (VOUT1); also elsewhere on the board
unnamed: C16.1, R59.1
unnamed: C16.2, J15.1
unnamed: C17.1, R60.1
unnamed: C17.2, J16.1
unnamed: C18.1, U8.2 (BYPASS), U8.3 (Vin(+))
unnamed: C19.1, U9.2 (BYPASS), U9.3 (Vin(+))
unnamed: C20.2, R59.2, R61.1, U8.4 (Vin(-))
unnamed: C21.2, R60.2, R62.1, U9.4 (Vin(-))
SPKR_OUT1_N: U9.8 (VOUT2); also elsewhere on the board
SPKR_OUT1_P: C21.1, R62.2, U9.5 (VOUT1); also elsewhere on the board
~STBY: U8.1 (~STBY), U9.1 (~STBY); also elsewhere on the board

Notes on the sheet:
DNP

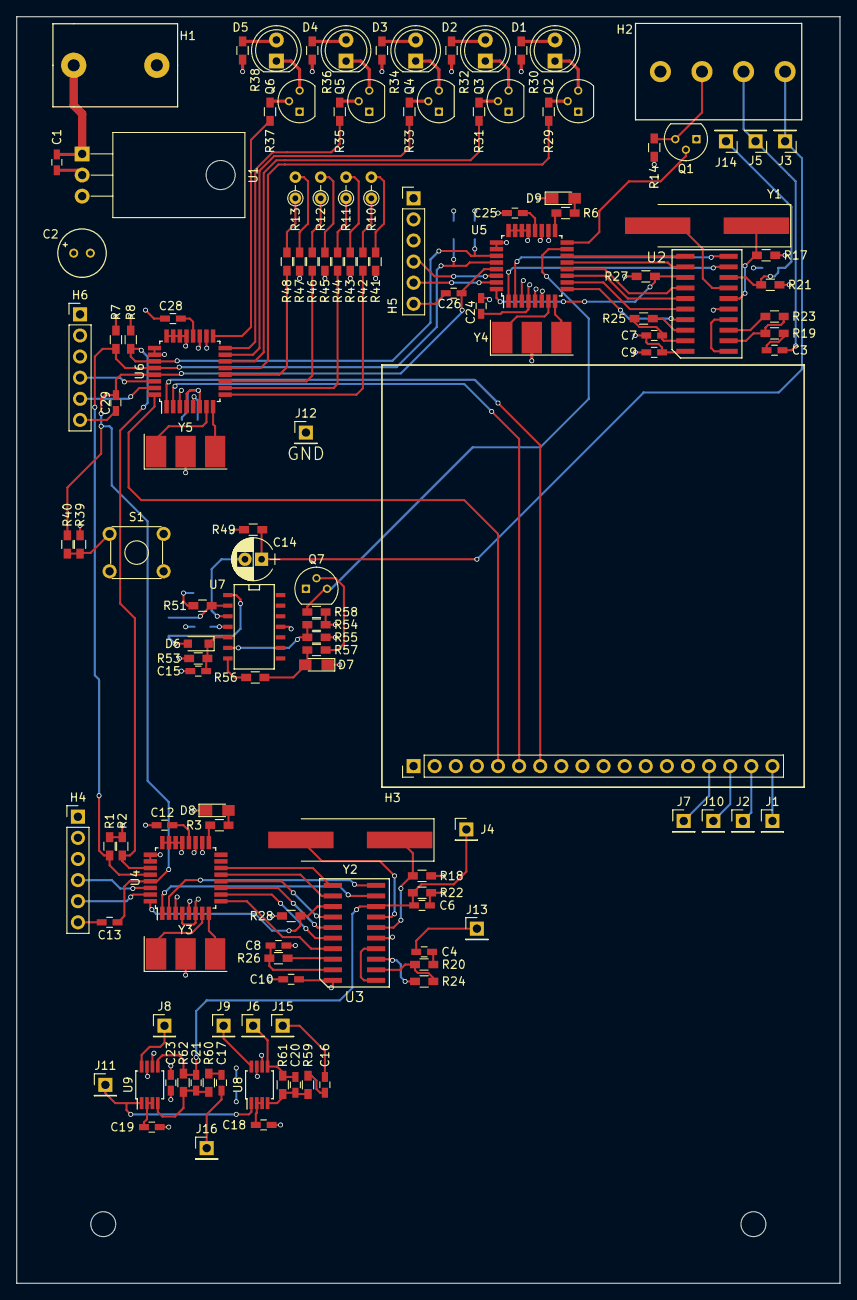
[picture p41: board Tardis.kicad_pcb from above]

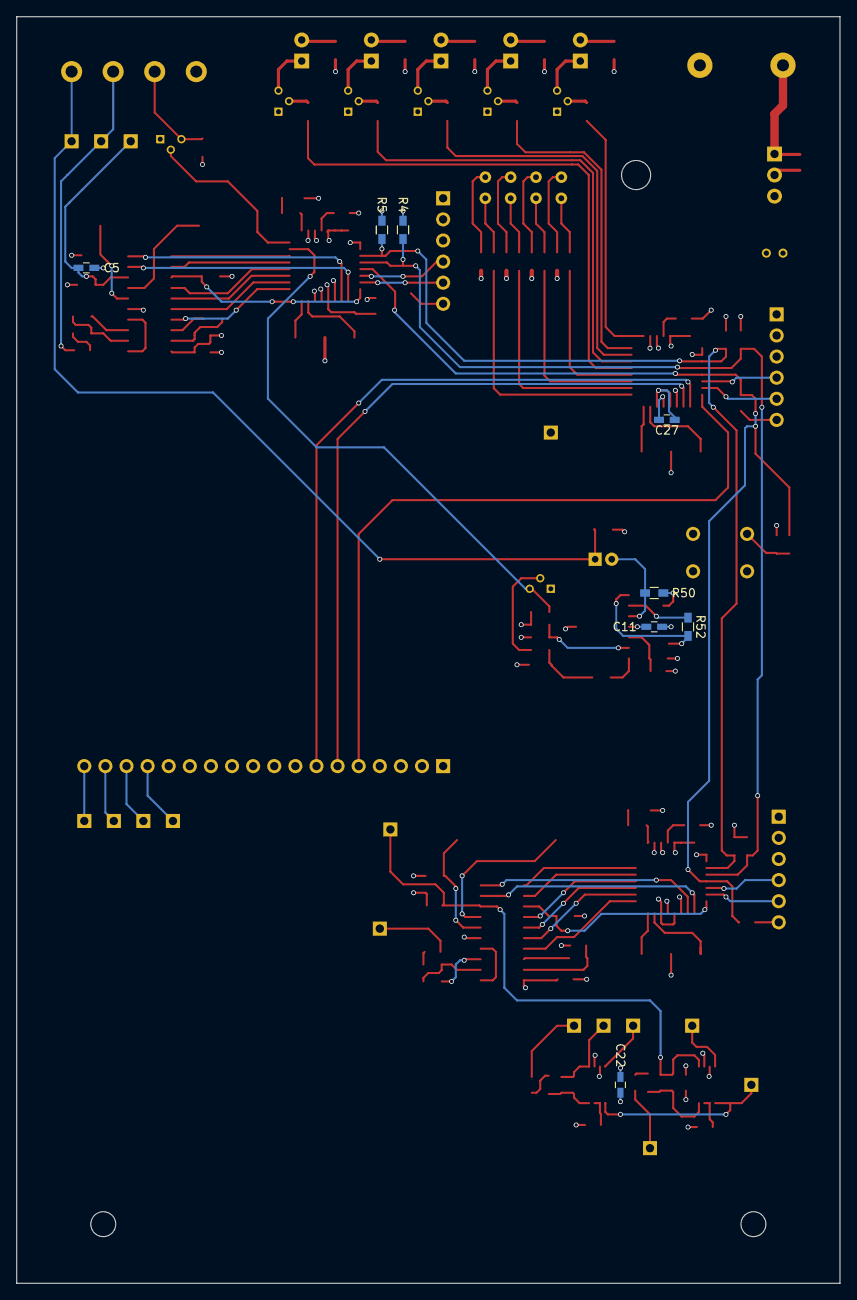
[picture p42: board Tardis.kicad_pcb from below]

Board: 4 copper layers, 99.1 x 152.4 mm, 141 parts (8 on the bottom side), 130 nets.
