BlueFrimFrim/Tardis/Receive_AVR/Tardis-working_revision/Tardis-5cc00eff65d057033157b48ef850f48163e142dd/misc/ReceiveTone/ReceiveTone.ino

#include "..\ReceiveTone\library\tardis.h"

t_buffer tone_buff;
uint8_t tone_data[TONE_SIZE];

volatile t_sysflgs sysflgs;

void setup() {
  // put your setup code here, to run once:
  BufferInit(&tone_buff, tone_data, (uint16_t)TONE_SIZE);
  Reset();
}

void loop() {
  if(sysflgs.irq_flg){
    sysflgs.irq_flg = 0;
    
  }
}
