BlueFrimFrim/Tardis/Receive_AVR/Receive_AVR/Receive_AVR/tardis.h

#ifndef TARDIS_H
#define TARDIS_H


/*----------------------------------------------*/
/*----------------------------------------------*/
/* ARDUINO LIBRARIES */
#include "Arduino.h"
#include <Wire.h>

/*----------------------------------------------*/
/* TARDIS LIBRARIES */
#include "buffer.h"
#include "dtmf.h"
#include "timeout.h"

/*----------------------------------------------*/
/* Definitions */
#define TONE_SIZE 256

/*----------------------------------------------*/
/* Type definitions */
const byte g_one = 1;
const byte g_two = 2;
const byte g_three = 3;
const byte g_four = 4;
const byte g_five = 5;
const byte g_six = 6;
const byte g_seven = 7;
const byte g_eight = 8;
const byte g_nine = 9;
const byte g_zero = 10;
const byte g_star = 11;
const byte g_hash = 12;


/*----------------------------------------------*/
/* Type definitions */
typedef struct
{
    uint8_t irq_flg;
}t_sysflgs;

#if 0
/*----------------------------------------------*/
/* Function declarations */
extern int TimeoutMilliseconds(unsigned long start, unsigned long timeout_ms);
extern void InitializeDTMF(void);
extern void MT8880C_RX_Init(void);
//extern void ProcessTone(uint8_t data);
extern void ExecuteCommand(uint64_t command);
extern unsigned Concatenate(unsigned x, unsigned y);
#endif
#endif /* TARDIS_H */
