BlueFrimFrim/Tardis/Receive_AVR/Receive_AVR/Receive_AVR/buffer.h

#ifndef BUFFER_H
#define BUFFER_H

#include "Arduino.h"

/*----------------------------------------------*/
/* Type definitions */
typedef struct
{
	uint16_t len;
	uint16_t wr_ptr;
	uint16_t rd_ptr;
	uint16_t buff_size;
	volatile uint8_t *data;

	uint64_t command;
} t_buffer;

#if 0
/*----------------------------------------------*/
/* Function declarations */
extern void BufferInit(t_buffer *buffer, volatile uint8_t *data, uint16_t size);
extern void BufferReset(t_buffer *buffer);
extern uint16_t BufferLength(t_buffer *buffer);
extern void BufferWrite(t_buffer *buffer, uint8_t data);
extern uint8_t BufferRead(t_buffer *buffer);
#endif
#endif /* BUFFER_H */
