BlueFrimFrim/Tardis/(commit log)

2016-11-26 Put tardis.ino in it's own folder so ArduinoIDE will be able torecognize it.
2016-12-04 Converted Diego's code. Not 100%, not working
    [main.c]
2017-01-25 arduino interrupts work.
2017-01-25 Interrupts work, receiving works.
2017-02-20 bug: interrupt hung when using serial
    [tardis_dtmf.ino]
2017-05-22 added 'mainframe' folder for stm32 mbed
2017-05-30 added Visual Studio Arduino project
2017-06-03 Tested, runs. Interrupts are a bit iffy.
2017-07-21 commented out dtmf, tested 5 minute timer
2017-08-22 5 second timer works
2017-08-24 30 minute timer works
2017-09-04 io expander doesn't work
    [MCP23S17.cpp, Receive_AVR.ino, dtmf.cpp]
2017-12-10 Added test comment for GitKraken
    [Arduino1.sch, Arduino2.sch, Arduino3.sch, Buttons.sch, LedArray.sch, PTT.sch, Tardis.kicad_pcb, Tardis.sch]
2017-12-10 Added KiCad PCB Files
2017-12-12 Added jumpers to bypass amp
    [Arduino1.sch, Arduino2.sch, Arduino3.sch, Buttons.sch, LedArray.sch, PTT.sch, Tardis.sch, tonefiltering.sch]
2017-12-16 Adding footprints
    [Tardis.sch]
2017-12-17 Adding footprints cont.
    [Arduino1.sch, Arduino2.sch, Arduino3.sch, Tardis.sch]
2018-01-12 Added PCB layout
    [Arduino1.sch, Arduino2.sch, Arduino3.sch, Buttons.sch, LedArray.sch, PTT.sch, Tardis.dsn, Tardis.sch]
2018-01-14 PCB Done. To be reviewed.
    [Arduino1.sch, Arduino2.sch, Arduino3.sch, Buttons.sch, LedArray.sch, PTT.sch, Tardis.kicad_pcb, Tardis.sch]
2018-01-14 Added gerbers.
    [Tardis-B.Cu.gbr, Tardis-B.Fab.gbr, Tardis-B.Mask.gbr, Tardis-B.Paste.gbr, Tardis-B.SilkS.gbr, Tardis-Dwgs.User.gbr, Tardis-Edge.Cuts.gbr, Tardis-F.Cu.gbr]
2018-01-18 added 0.15inch clearance to edges
    [Tardis.kicad_pcb]
2018-01-21 new gerbers
    [Tardis-B.Cu.gbr, Tardis-B.Fab.gbr, Tardis-B.Mask.gbr, Tardis-B.Paste.gbr, Tardis-B.SilkS.gbr, Tardis-Dwgs.User.gbr, Tardis-Edge.Cuts.gbr, Tardis-F.Cu.gbr]
2018-06-15 Removed Raycast, implemented spawning bullets.
    [Tardis-B.CrtYd.gbr, Tardis-B.Cu.gbr, Tardis-B.Fab.gbr, Tardis-B.Mask.gbr, Tardis-B.Paste.gbr, Tardis-B.SilkS.gbr, Tardis-Cmts.User.gbr, Tardis-Eco1.User.gbr]
2018-06-28 Adding button/led functionality
